haoy1657/stage_2021_pprime/rapport/Rapport technique .pdf

# Rapport technique

Stage de technicien supérieur en conception mécanique Institut P’ CNRS UPR3346 – département GMSC – équipe ROBIOSS du 12 avril 2021 au 18 juin 2021

Hao Yuan

Etudiant
Génie Mécanique et Productique
Institut Universitaire de Technologie de Poitiers M Antoine Eon

Tuteur de stage
Maître de Conférence
M Arnaud Decatoire

Tuteur de stage
Ingénieur de Recherche

M Julian Le rouzic

Enseignant référent
Génie Mécanique et Productique Institut Universitaire de Technologie de Poitiers

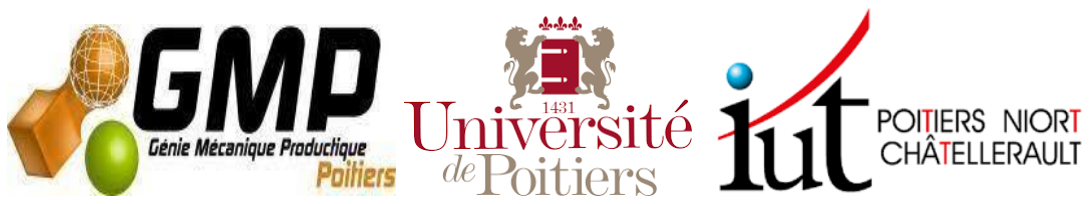
[picture p16: figure]

## Sommaire

Sommaire | 2
Introduction | 3
Missions | 4
Missions 1:l’analyse cinétique et dynamique et l’inertie d’utilisateur | 4
l’analyse cinétique et dynamique | 4
L’inertie d’utilisateur | 7
Mission 3:Dimensionnement du plateau et la roue | 11
1.La roue | 11
2.Le plateau | 15
Mission 3: conception sur Solidworks | 18
Conclusion | 20

## Introduction

Dans le cadre de mes études, j’ai réalisé un stage de dix semaines au sein du laboratoire l’institut pprime (cnrs). L’institut P’ est un laboratoire de recherche des domaines des Sciences Physiques et des Sciences de l’Ingénierie. Pendant ce stage ,j’ai travaillé pour concevoir un dispositif qui permet d’illustrer la loi de conservation du moment cinétique.Ce dispositif est composé en deux parties , la première partie consiste en un plateau permettant une rotation libre autour de l’axe vertical,La deuxième partie correspond à une roue motorisée tenue par les élèves / utilisateurs. Le mouvement de rotation (vitesse angulaire) de cette roue doit pouvoir être pilotée par les élèves / utilisateurs.C’est pour ca que le mase de la roue ne doit pas etre tres lourd,on a pris deux kg comme son masse,et on joue principalement sur sa vitesse de rotation.quand l’angle du bras est nul , Qu'il change de vitesse ou de poids de roue, le plateau ne peut pas tourner.Donc pour le rendre bien fonctionner , l’angle du bras d’utilisateur (theta 2) ne doit pas être nul.
Dans ce rapport , je vais présenter principalement trois missions
La première mission concerne l'analyse cinétique et dynamique,c’est pour essayer de trouver l’équation de mouvement qui lie l'inertie de la roue et la vitesse de rotation du plateau, cette équation nous permet de dimensionner le plateau et la roue.Dans l’équation du mouvement, on a constaté qu’il concerne une constante (B1 l’inertie du corps de l’utilisateur ), pour obtenir la valeur B1, on a établir un tableau d’excel pour calculer les inerties d’utilisateur automatiquement .
La deuxième mission concerne le dimensionnement du plateau et de la roue ,tout d’abord,on a établi un tableau de simulation selon l’équation du mouvement, c’est pour trouver les valeurs le plus pertinent (l’inertie de la roue, sa masse…..) pour que la vitesse de rotation du plateau ne soit pas très élevée.Pour le dimensionnement du plateau ,principalement,on a travaillé pour choisir le bon roulement (le plue économique , la durée de
vie | ), pour faire ca , on a proposé sept contraintes et établi un grand tableau (il y a 600
roulement dedans ),finalement l’excel nous a proposé 12 roulements ,parmi ces 12 roulements ,on a choisi le roulement 7207 BE-2RZP, parce que ce roulement est déjà étanche,c’est très pratique.
Après avoir terminé ces deux missions précédentes , on a travaillé sur solidworks pour la modélisation de la conception , mais malheureusement , on a pas eu temps pour concevoir et modéliser la roue, pour le plateau ,on l’a bien modélisé.Et ça ,c'est la troisième mission

## Missions

### I. Missions 1:l’analyse cinétique et dynamique et l’inertie d’utilisateur 1. l’analyse cinétique et dynamique

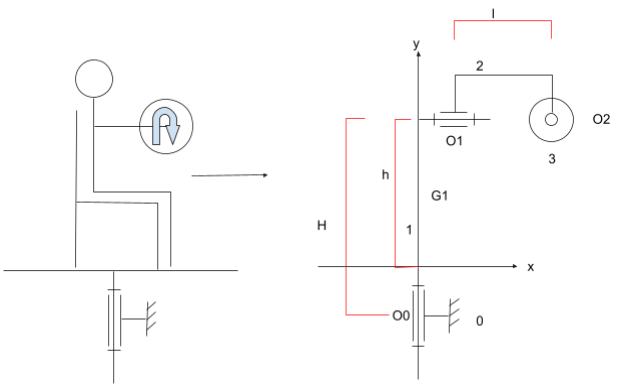
[picture p17: figure]

Illustration 1 la modèle simple

La premier mission pour moi est l’analyse cinétique et dynamique , ce calcul m’a occupé plus de trois semaines , les connaissances qu’on a utilisé ne sont pas très difficiles , elles sont toutes enseignées à l'iut, mais il y a nombre de variables , ca a rendu le calcul plus complexe,mais finalement j’ai réussi à le finir.
L’objectif pour l’analyse cinétique et dynamique est d' essayer de trouver une équation qui lie l’inertie de la roue et le plateau. On veut trouver cette équation, c’est parce qu’on veut contrôler la vitesse de rotation du plateau pour qu’il ne soit pas très rapide( Dans la simulation derrière , on prend PI/2 comme le valeur maximum de la vitesse.)
Pour faciliter le calcul , on a supposé qu’il y a quatre solides(0- le bâti,1-le corps principal d’utilisateur+le plateau,2-les deux bras d’utilisateur,3-la roue), Chacun a un système de coordonnées unique:

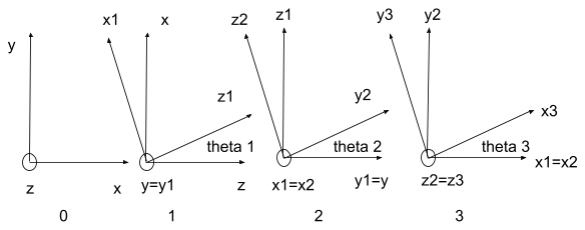
[picture p18: figure]

Illustration 2 les systèmes de coordonnées des solides

Les hypothèses qu’on a fait avant le calcul:

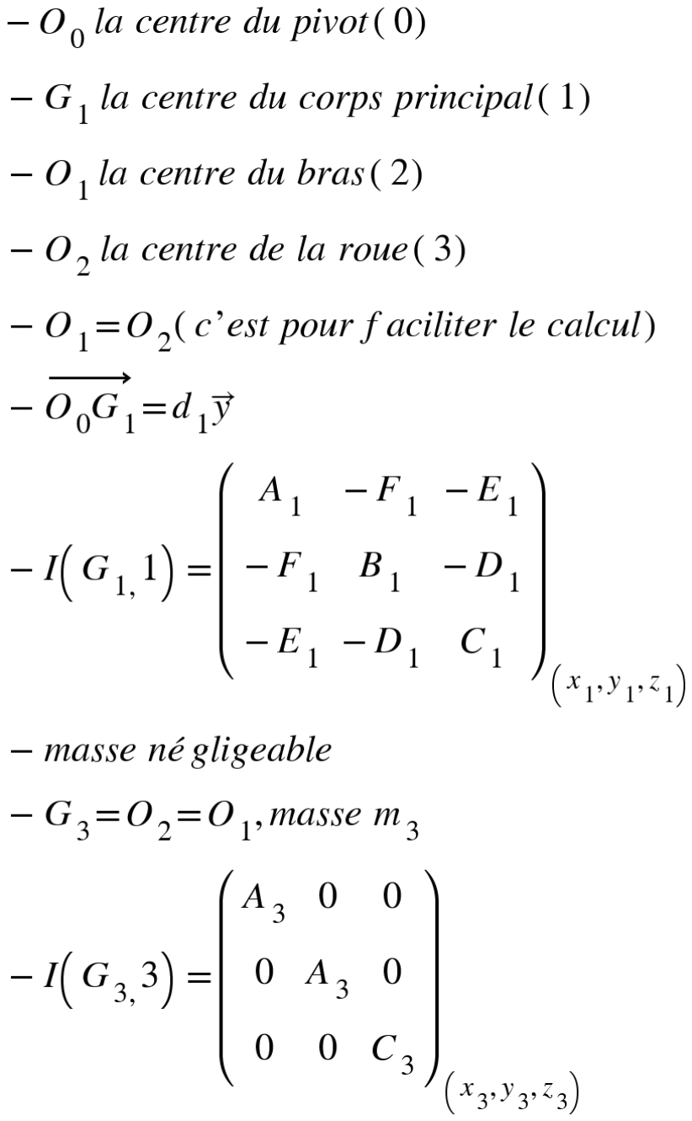
[picture p19: figure]

Bilan action mécanique
-pesanteur sur 1 et 3
-Couple moteur de 2->3 en O2 /z2 -Couple humain e 1->2 en O2/x1

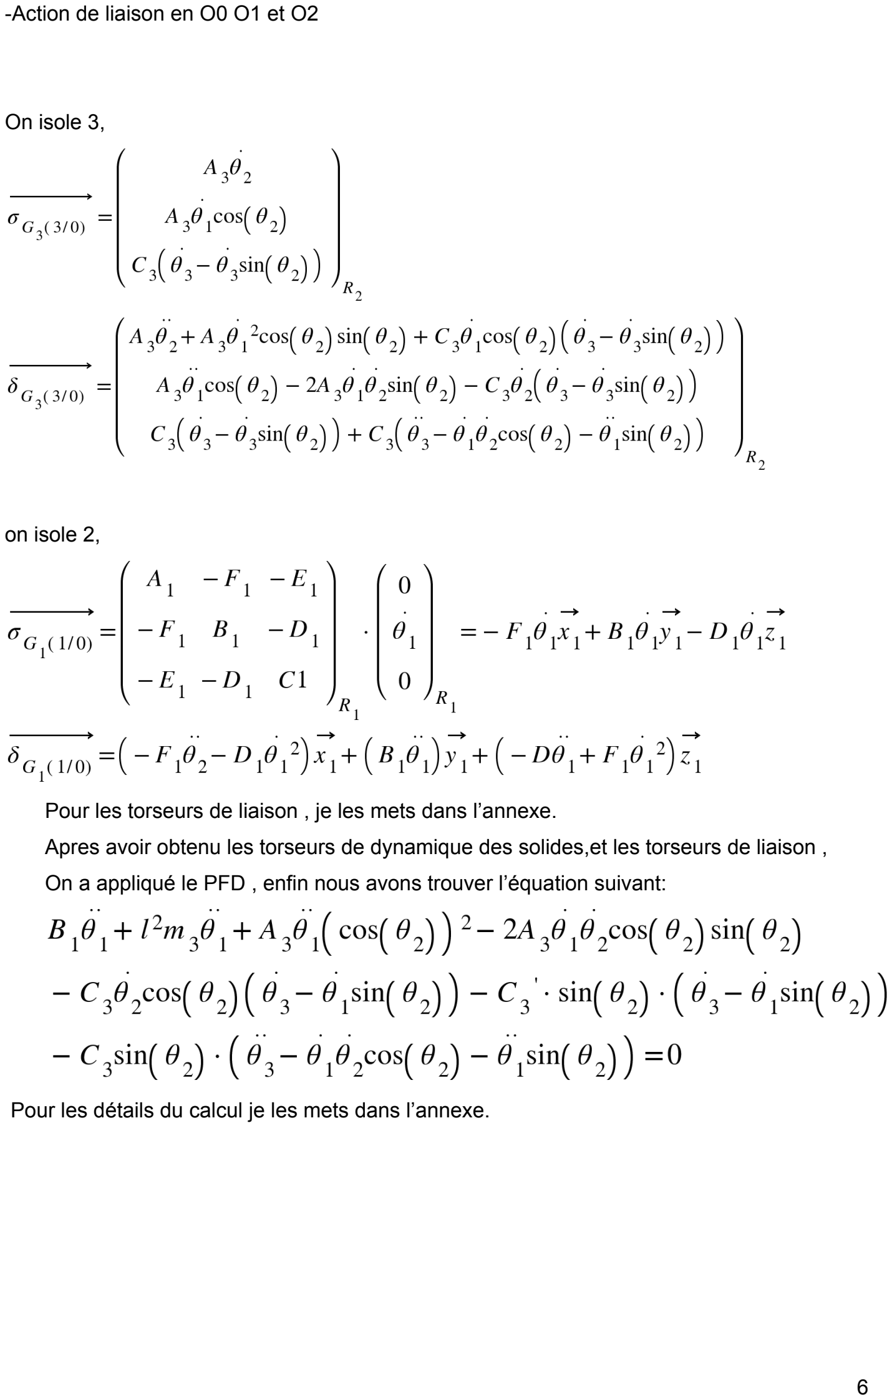
[picture p20: page 6]

-Action de liaison en O0 O1 et O2

On isole 3,

on isole 2,

Pour les torseurs de liaison , je les mets dans l’annexe.
Apres avoir obtenu les torseurs de dynamique des solides,et les torseurs de liaison , On a appliqué le PFD , enfin nous avons trouver l’équation suivant:

Pour les détails du calcul je les mets dans l’annexe.

### 2. L’inertie d’utilisateur

Dans l’équation précédent , on constate qu’il a une constante d’inertie du corps(B1) Donc on doit essayer de trouver la valeur de B1 pour qu’on puisse faire la simulation suivante.

En biomécanique, le corps humain peut être vu comme composé de nombreuses parties différentes.Si on veux calculer l’inertie d’un humain, il faut calculer l’inertie de chaque partie , Les inerties calculées ne sont pas appliquées en même point , on a utilisé le théorème de HUYGENS.
Le théorème de Huygens permet de relier les moments d'inertie d'un solide par rapport à un axe et du solide par rapport à l'axe parallèle à et passant par G : où a désigne la distance entre les deux axes de rotation.
Voici est la formule du théorème de Huygens

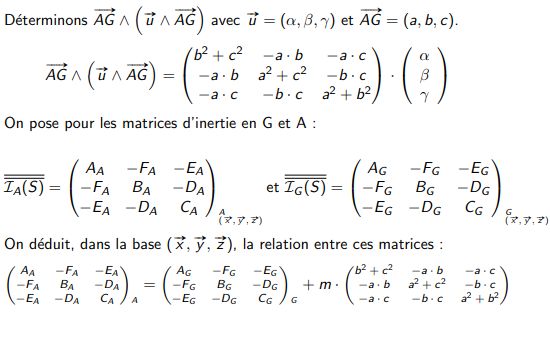
[picture p21: figure]
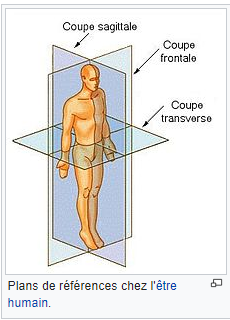
[picture p22: figure]

Il y a aussi autre chose qui doit être fait pendant ce calcul ,c’est d’appliquer le système de référence en anatomie pour chaque partie de corps,parce que l’inertie des différentes parties qu’on a obtenue finalement sont appliquées en leur propre système de coordonnées.Nous devons tous les convertir dans le même système de coordonnées(sagittale, frontale, transversale)

ETAPE 1 calculer le coefficient de corrélation
La première chose que nous devons faire est de calculer le coefficient de proportionnalité entre la masse et la longueur de chaque partie du corps humain et la hauteur et la masse totale du corps humain sur la base d'un échantillon de table.Ce tableau est un exemple de tableau résumé par des chercheurs sur la base de données massives. Voici le tableau :

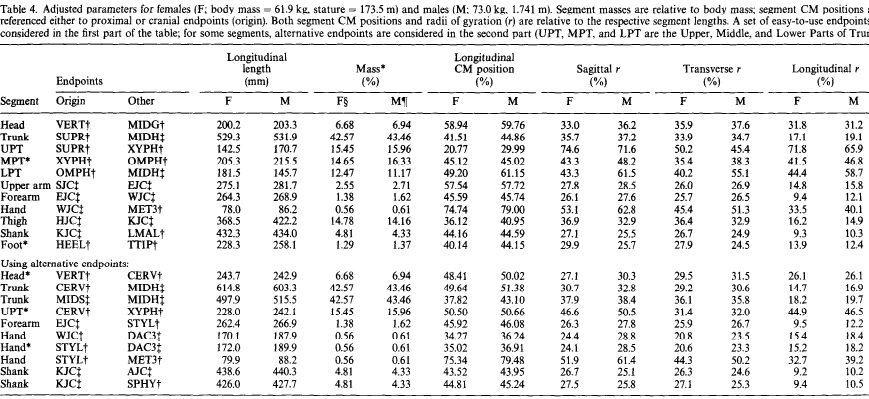
[picture p23: figure]

Illustration 3 tableau résumé Je vais ajouter ce tableau dans l'annexe , ça sera plus clair pour vous. Finalement , on a obtenu le tableau de coefficient ci dessous

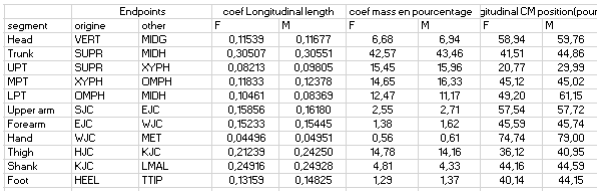
[picture p24: figure]

Illustration 4 tableau du coefficient Avec ce tableau, nous pouvons calculer la masse et la longueur de chaque partie de l'utilisateur en fonction de sa taille et de son poids.Nous pouvons aussi savoir la position de la centre d’inertie avec ce tableau.Parce que ce tableau contient également les informations de la position de la centre de masse.
La figure suivante est plus claire，La position du point de masse est à 44,86 pourcent de la longueur totale du tronc.

Illustration 5 position du point de masse

Etape 2 Application du théorème de HUYGENS

La formule du HUYGENS est pour changer le point appliqué d’inertie.il faut savoir le vecteur AG tout d’abord.
Le vecteur sert à calculer une matrice qui est une partie de cette formule

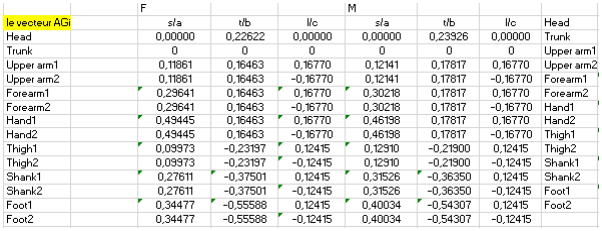
[picture p25: figure]

Illustration 6 matrice du vecteru AG Selon ce tableau on sait les trois valeurs (a,b,c),et puis on fait le calcul comme le tableau ci dessous

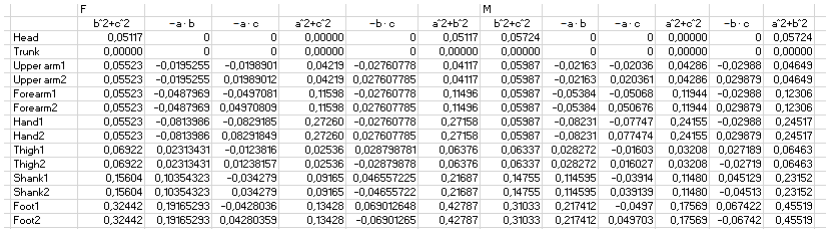
[picture p26: figure]

Illustration 7 matrice calculé

Nous ajoutons la valeur obtenue dans le tableau ci-dessus à sa propre inertie(l’inertie en sa centre de gravité),on obtient les l’inertie en la centre de gravité du corps global.
Et puis , on ajoute tous les résultats pour obtenir l’inertie totale du corps au centre du tronc,comme le tableau ci dessous

Illustration 8 l’inertie totale du corps au centre du tronc Ces inerties qu’on a obtenu ne sont pas appliquées au centre du corps , il est au centre du tronc.Donc on doit le convertir au centre du corps en utilisant HUYGENS.
Avant le calcul, il nous faut savoir la position du centre du corps en utilisant le théorème BARYCENTRE.
Voici est le tableau l’inertie du corps au centre:
Illustration 9 l’inertie totale du corps au centre du corps

On doit connaître l’inertie du plateau aussi puisqu'on pense que le plateau et l’humain sont dans le même solide(1)
Avec solidworks , nous pouvons connaître l’inertie d’une solide facilement ,solidworks peut nous aider à calculer l’inertie d’un solide lui-même.

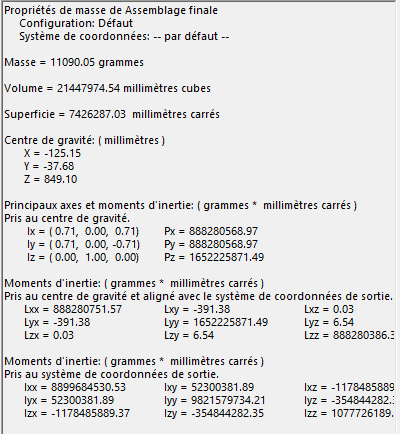
[picture p27: figure]

Illustration 10 l’inertie du plateau donné par solidworks

Et enfin , on a ce tableau qui nous dit l’inertie du corps et plateau en la centre du corps en les ajoutant:

Illustration 11 l’inertie du plateau et d’humain

### II. Mission 3:Dimensionnement du plateau et la roue

1.La roSue

La roue est composée en trois parties comme l’illustration ,la vitesse de la rotation et l’inertie peuvent être contrôlées par l’ordinateur à distance.

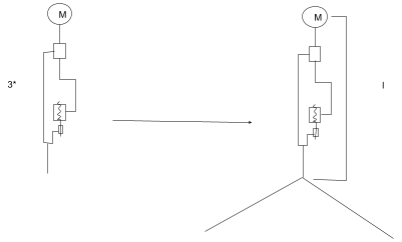
[picture p28: figure]

Illustration 12 la modèle de la roue Dans la première mission, on a trouvé une équation qui lie l’inertie de la roue et la vitesse de rotation du plateau ,et nous avons aussi établir une tableau d’excel pour calculer la matrice d’inertie du corps et plateau en le centre de gravité du corps.Cette simulation a l’objectif de trouver une valeur pertinente de l'inertie et des autres paramètres de la roue pour que la vitesse de rotation de la roue ne soit pas très rapide.
Nous avons proposé deux cas pour la simulation de la roue.

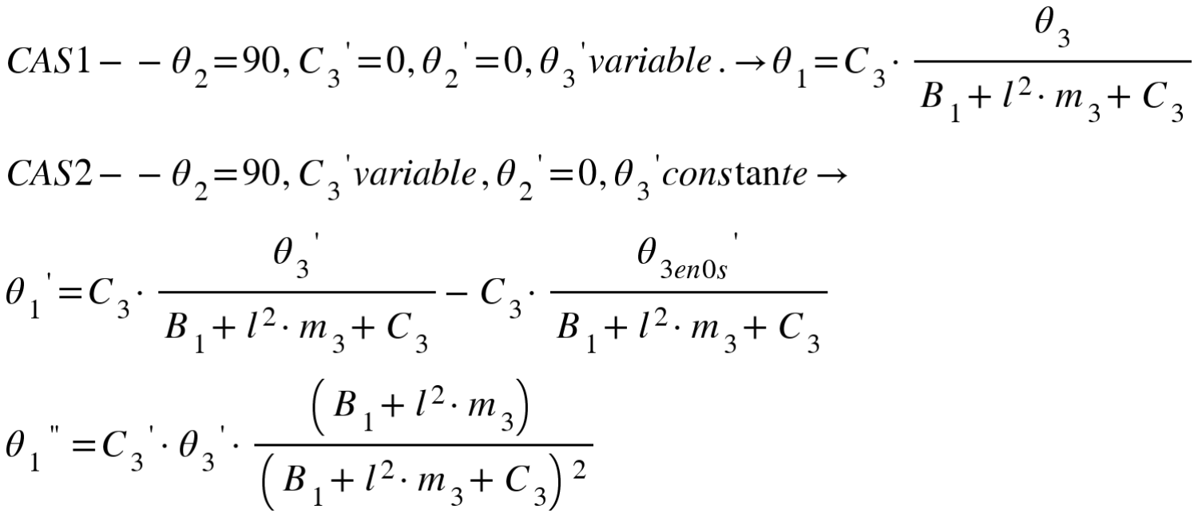
[picture p29: figure]

Le premier cas : l’angle du bras est une constante (PI/2),l’inertie de la roue est une constante ,on joue sur la vitesse de rotation de la roue ,si on veut laisser le plateau tourner, l’accélération de la roue ne doit pas être zéro.On a proposé un modèle comme ci-dessous:

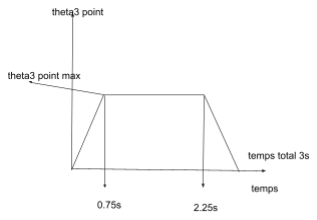
[picture p30: figure]

Illustration 13 theta 3 point en fonction du temps

Le deuxième cas:l'angle du bras est une constante(PI/2),la vitesse de rotation de la roue est une constante, l’inertie variable. Pareil, on a proposé un modèle pour C3 point:

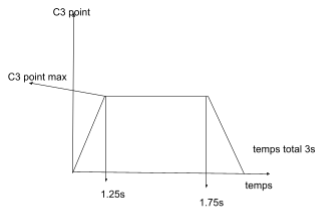
[picture p31: figure]

Illustration 14 C3 point en fonction du temps Et puis on a établi un tableau de résultat de simulation selon les deux cas proposés et les équations:

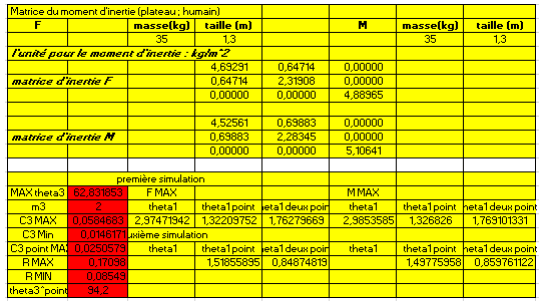
[picture p32: figure]

Illustration 15 résultat de simulation

Cette table est construite sur la base d'une énorme table de simulation,

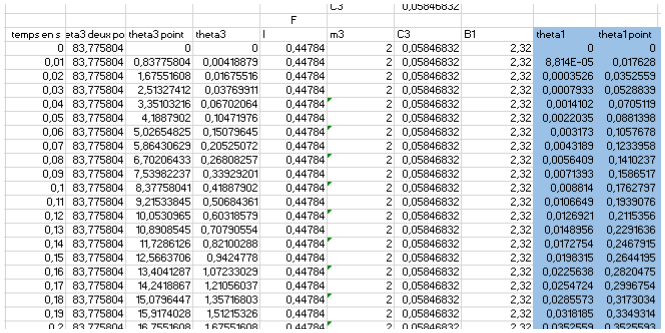
[picture p33: figure]

Dans l’illustration 15 ,le tableau en haut est le tableau d’inertie d'humain et du plateau,le tableau en bas est le tableau de simulation ,les valeurs en rouge sont les paramètres qu’on peut modifier, quand on modifie les valeur en rouge ,les résultat de la simulation change aussi.Nous avons voulu trouver les meilleur paramètres pour que la vitesse de rotation du plateau ne soit pas très rapide.La roue doit etre tenu par les utilisateur , c’est pour ca que le mase de la roue ne doit pas etre tres lourd,on a pris deux kg comme son masse,et on joue principalement sur sa vitesse de rotation.quand l’angle du bras est nul , Qu'il change de vitesse ou de poids de roue, le plateau ne peut pas tourner.Donc pour le rendre bien fonctionner , l’angle du bras d’utilisateur (theta 2) ne doit pas être nul.
Enfin, après plusieurs simulations,nous avons proposé deux modes (mode enfant ,mode adulte):

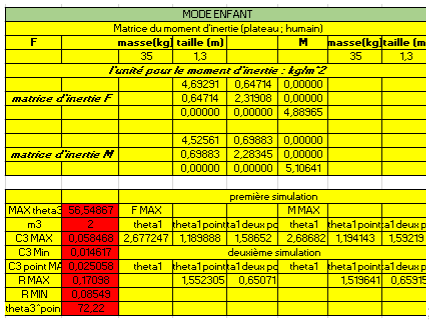
[picture p34: figure]

;
Illustration 16 mode enfant

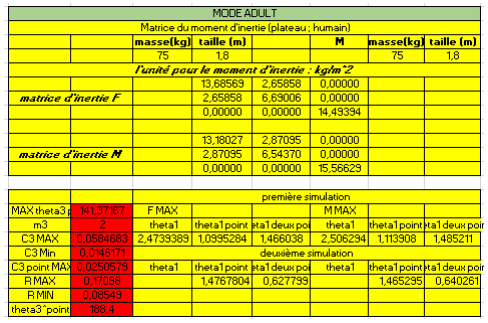
[picture p35: figure]

Illustration 17 mode adulte (Lors de la simulation, nous avons constaté que la masse de la roue a peu d'effet sur la vitesse du plateau , on prend en compte principalement C3 et theta 3)

2.Le plateau

Le plateau est composé en trois parties , la première partie est le disque en bois,Le diamètre de ce disque est d'un mètre et l'épaisseur est
de deux centimètres.La deuxième partie est le bâti en métal (aluminium),on a choisi le motedis 45*45,
La troisième partie est le boîtier du roulement ,dans le dimensionnement du plateau , le choix du roulement est le plus important.
On a plusieurs type de roulement qui peuvent être choisi:
-un montage du roulement avec contact oblique(bille,rouleau)
-un roulement combiné
-un roulement rouleaux croisé
Pour le troisième roulement , mon équipe en a trouvé un pertinent , son prix est 240 euros,moi j’ai travaillé sur le choix du premier type roulement-un montage du roulement avec contact oblique(bille,rouleau).Enfin , on a comparé les prix des roulement ,Choisissant le roulement le plus économique.

Pour choisir le roulement , on a proposé cinq contraintes:
->charge statique équivalente doit être inférieur à charge statique de la base du roulement (P0<C0).
->durée de vie du roulement doit être supérieur à 20000h.

->le contrainte(la traction et le cisaillement) doit être inférieur à la limite élasticité du matériaux avec “k=2”.
->l’angle de déformation en les points du roulement doit être inférieur à deux minutes d’angle(Pi/5400). il est donné par le constructeur
->la distance au dessus et au dessous des deux roulements doit être inférieur à l'épaisseur de ces deux roulement (h>2*B).
--le travaille sur solidworks, effectuer la modélisation selon les dimensions qu’on a obtenues.
Ce roulement doit avoir une longue durée de vie et être capable de résister à la gravité de l'utilisateur.Dans le même temps, le diamètre intérieur du roulement détermine l'épaisseur de l'arbre et le diamètre de l'arbre doit pouvoir résister à une force suffisante.
La première chose que j’ai faite était d'établir un tableau avec tous les paramètres des roulements (d,D,B,C,C0,X,Y0,Y1,Y2,e), ces paramètres peuvent être trouvés sur le site SKF.

Et puis on doit calculer sa Charge dynamique équivalente et Charge statique équivalente
Dans le dossier du constructeur ,on y a trouvé le modèle du calcul pour ce type de roulement.

Le modèle du calcul du roulement :
Charge dynamique équivalente-> Roulements isolés et appariés en tandem :
Fa/Fr ≤ e → P = Fr
Fa/Fr > e → P = X Fr + Y2 Fa.
Roulements montés par paire selon disposition en O ou en X Fa/Fr ≤ e → P = Fr + Y1 Fa
Fa/Fr > e → P = X Fr + Y2 F
Charge statique équivalente->
Roulements isolés et appariés en tandem :
P0 = 0,5 Fr + Y0 Fa
P0 < Fr → P0 = Fr
Roulements montés par paire selon disposition en O ou en X : P0 = Fr + Y0 Fa.

On a ajouté la méthode du calcul dans le tableau ,et puis , on a calculé la durée de vie des différentes des roulements.

Après avoir chercher des informations sur le site ,on a trouvé une caractéristique des roulements.Dans ce document , il est indiqué que le défaut d'alignement admissible est 2 minutes d'angle pour montage en O, et 4 minutes d'angle pour montage en X.

Donc on a calculé l’angle déformation pour chaque roulement.

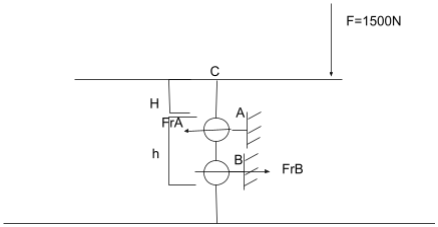
[picture p36: figure]

Illustration 18 modèle du plateau

Après calcul ,l’angle déformation en roulement A:

L’angle déformation en roulement B: | .
Et puis on a ajouté ces deux formules dans le tableau.
Dans le processus de calcul, nous avons également trouvé une formule :Fr*h=F/2=750

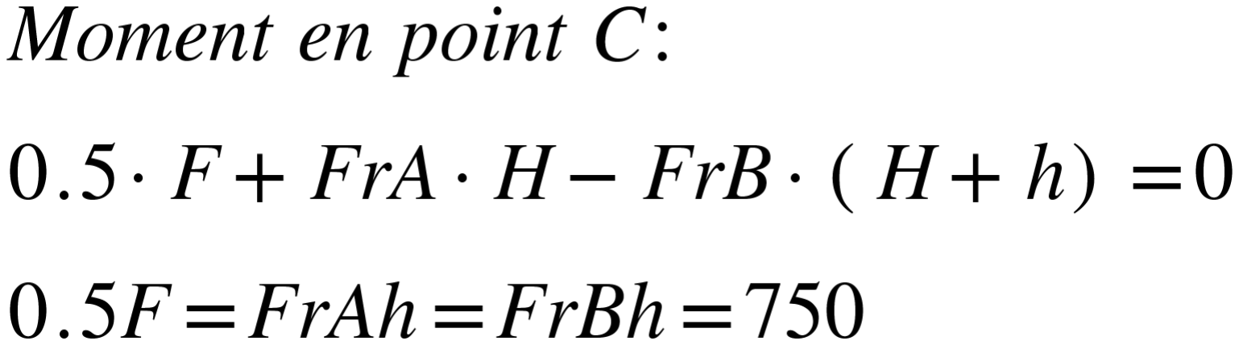
[picture p37: figure]

Après avoir terminé le formulaire, nous avons commencé notre simulation，On veut savoir quel roulement est le moins cher si la valeur h est la plus petite.Finalement , on a trouvé , le valeur le plus petit pour h est 35 mm, dans ce cas , on a 12 roulements au choix.

On a pris le roulement 7207 BE-2RZP,parce que ce roulement est étanche.Dans la partie de montage , on a pas besoin de monter un étanchéité.

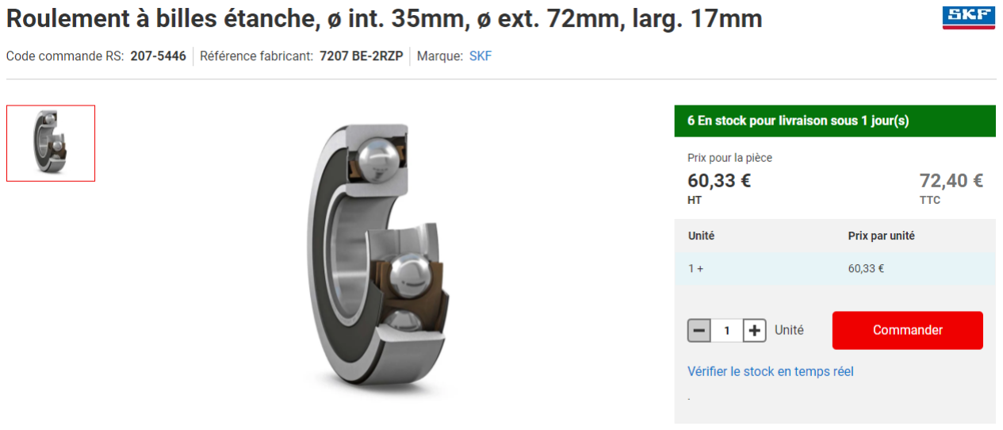
[picture p38: figure]

Illustration 19 Le prix du roulement 7207 BE-2RZP sur 123roulement Le prix pour ce roulement est 72..40 euros , il est inférieur à 240 euros, c’est plus économique de prendre ce roulement.

### Mission 3: conception sur Solidworks

Après de dimensionnement ,on a commencé conception sur solidworks,et voici est la modèle du plateau j’ai conçu:

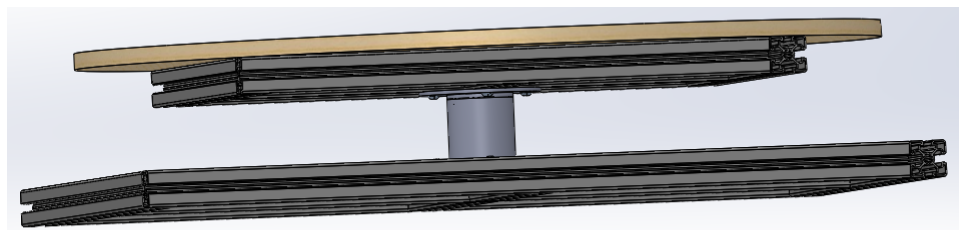
[picture p39: figure]

Illustration 20 modèle du plateau sur solidwork

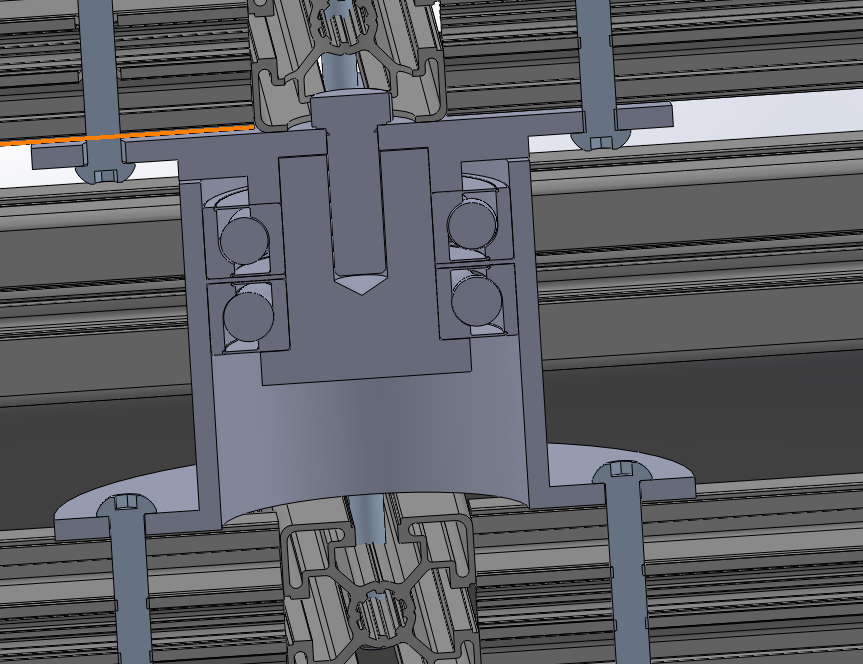
[picture p40: figure]

Illustration 21 vue de coupe

et voici est la vue de coupe du boîtier du roulement.il y a du jeu entre l'arbre et la plaque haute, c’est pour régler la précharge , quand on serre la vis de serrage, ce jeu diminue, et la précharge augmente.

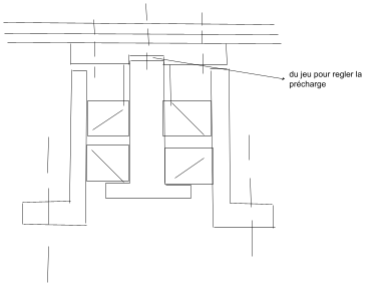
[picture p41: figure]

Illustration 22 le jeu pour régler la précharge Pour le conception du plateau , j’ai pas eu le temps pour le finir.Mais l'idée est claire ,les paramètres pour la roue sont bien trouvés.Nous devons juste trouver un moyen de transformer nos idées en réalité.

## Conclusion

J'ai la chance d'avoir pu faire un stage de deux mois dans le laboratoire du CNRS, ce qui a grandement renforcé mes connaissances que j’ai apprises à l’IUT.
La tâche qui m'a été confiée est pratiquement terminée，il manque juste la conception de la roue,mais l'idée de base a été donnée dans le rapport.

Pour faire simple, j'ai réalisé trois points dans ce stage，tout d’abord,j’ai fait l’analyse cinétique et dynamique et l’inertie d’utilisateur, c’est pour trouver l’équation du mouvement
qui | peux | etre | utilisée | dans | la | simulation.

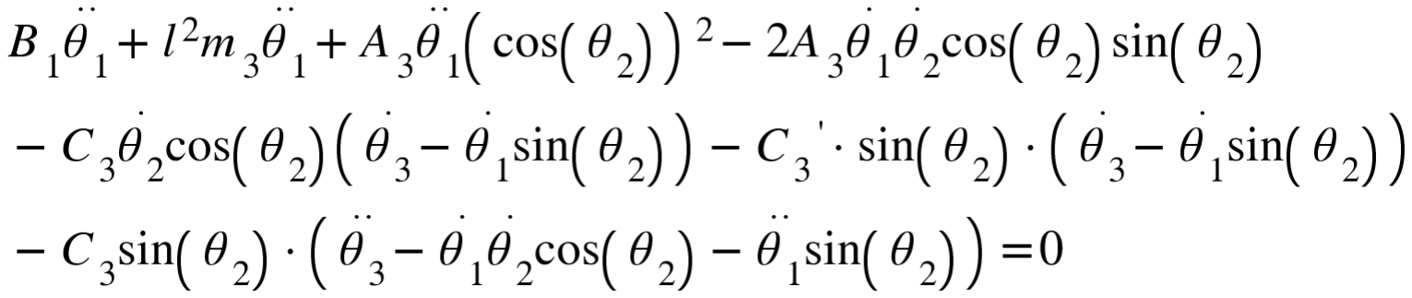
[picture p42: figure]

l’équation du mouvement
Et puis j’ai fait le dimensionnement du plateau et la roue ,proposé des paramètres de fonctionnement .Pour le plateau ,la chose la plus importante est le choix du roulement ,après l’étude et la simulation, on a pris le roulement 7207 BE-2RZP, c’est un roulement étanche. Et pour la roue ,on a proposé deux modes de fonctionnement (enfant et adulte),sa masse totale est de 2 kg,le temps de fonctionnement de la roue doit être de 3s ,et les autres paramètres de la roue sont bien indiqués dans le rapport.
Finalement, j’ai travaillé sur Solidworks ,pour la modélisation du plateau.

Pour ces missions , aucune échéance particulière ne m’avait été indiquée. Aussi j’ai pu travailler à mon rythme tout en m'efforçant de fournir un résultat que j’espère suffisamment avancé pour qu’il puisse bénéficier à l'entreprise.

Je suis très reconnaissant au CNRS de m'avoir offert cette opportunité de stage,Si je dois me dire quel est mon plus gros gain durant ce stage，Je pense que c'est une attitude envers les choses, tant que les choses sont prises au sérieux, rien n'est impossible!
