haoy1657/stage_2021_pprime/rapport/ANNEXE.pdf

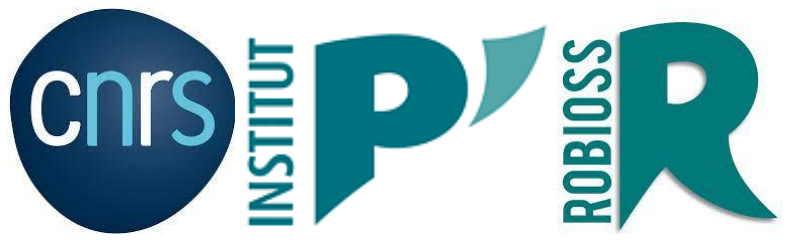
[picture p43: figure]

# ANNEXE

## Stage de technicien supérieur en conception mécanique

## Institut P’ CNRS UPR3346 – département GMSC – équipe ROBIOSS

## du 12 avril 2021 au 18 juin 2021

# Hao Yuan

## Etudiant

## Génie Mécanique et Productique

## Institut Universitaire de Technologie de Poitiers

# M Antoine Eon

## Tuteur de stage

## Maître de Conférence

# M Arnaud Dectoire

## Tuteur de stage

## Ingénieur de Recherche

# M Julian Le rouzic

## Enseignant référent

## Génie Mécanique et Productique

## Institut Universitaire de Technologie de Poitiers

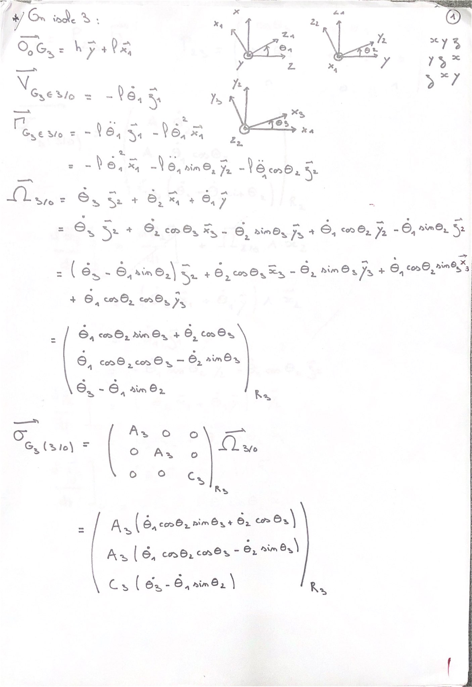
[picture p44: page 2]
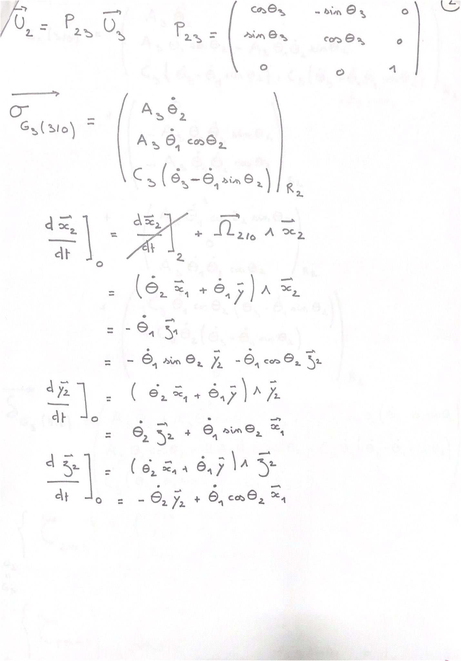
[picture p45: page 3]
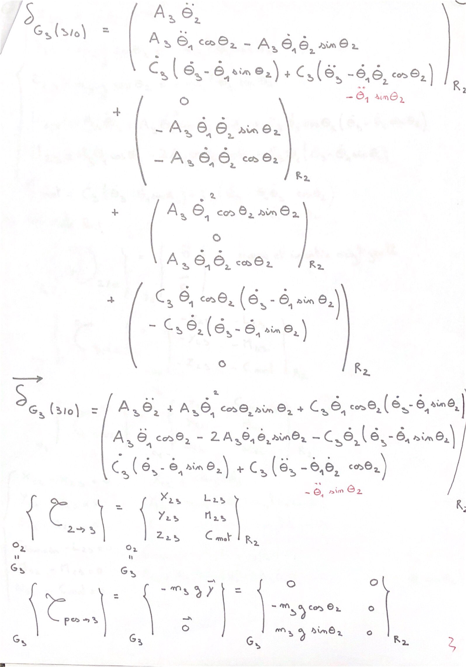
[picture p46: page 4]
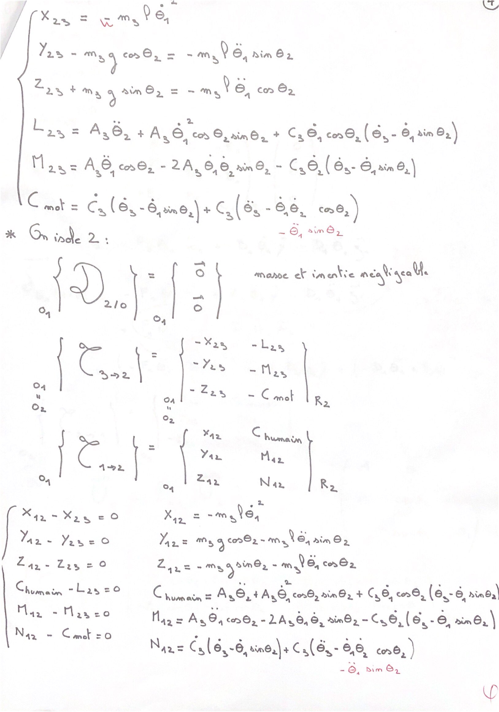
[picture p47: page 5]
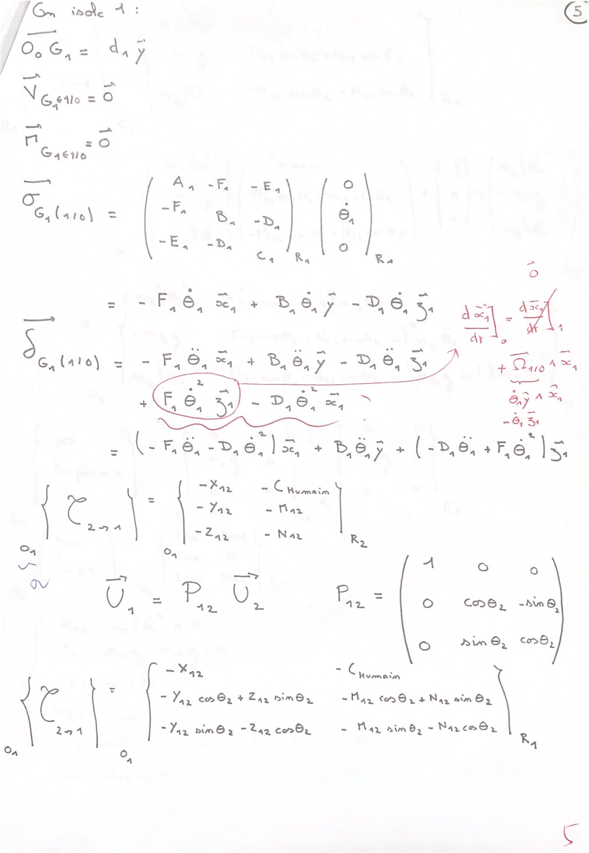
[picture p48: page 6]
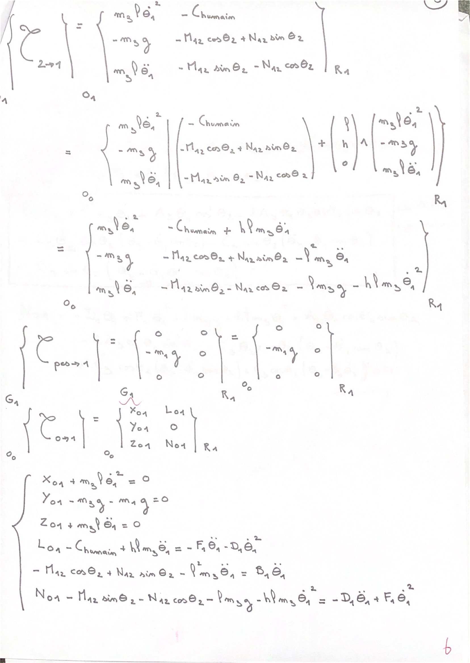
[picture p49: page 7]
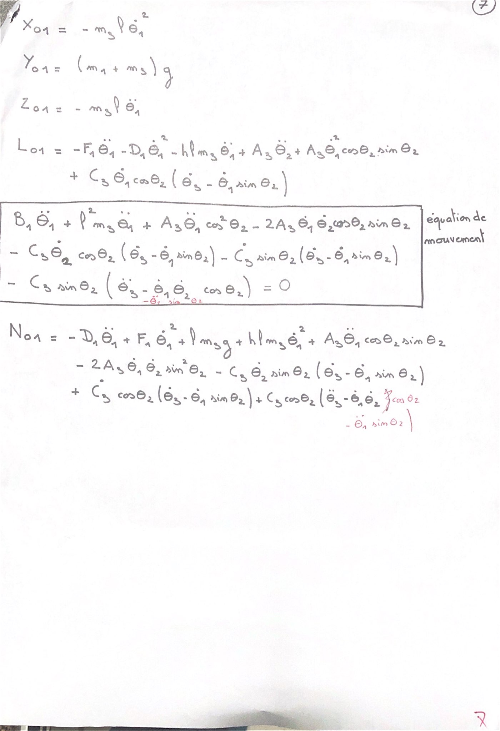
[picture p50: page 8]
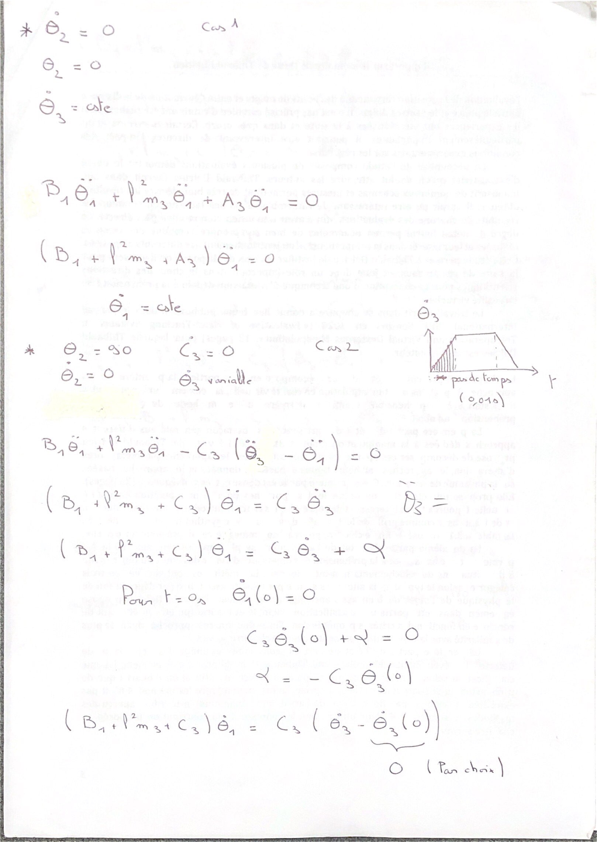
[picture p51: page 9]
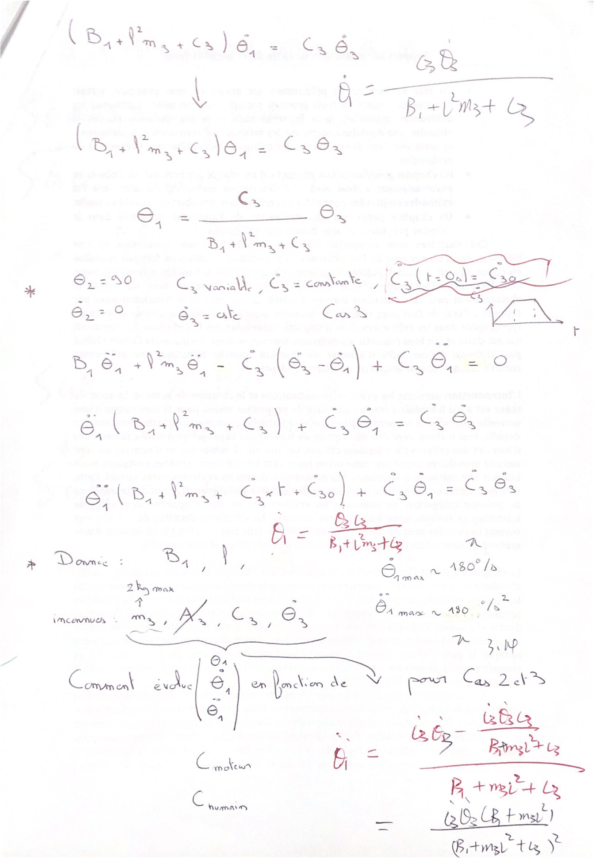
[picture p52: page 10]
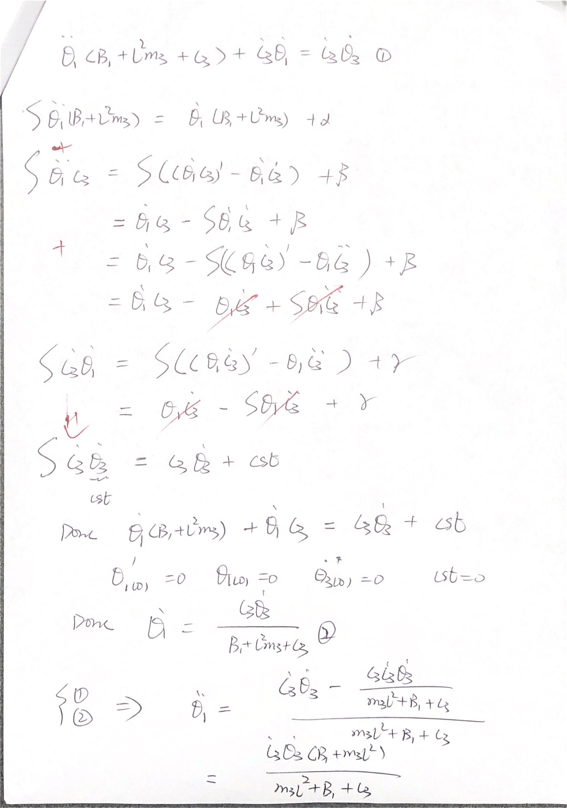
[picture p53: page 11]

## Op´erateur d’inertie

Th´eor`eme de Huygens g´en´eralis´e

On recherche la relation entre la matrice d’inertie en A du solide S et la matrice d’inertie en G le centre d’inertie du solide.

IA(S) ·

#»u =

Z

S

# » AM ∧

#»u ∧

# » AMdm

IG (S) ·

#»u =

Z

S

# » GM ∧

#»u ∧

# » GMdm

soit

IA(S) ·

#»u =

Z

S

# » AG +

# » GM

∧
#»u ∧

# » AG +

# » GMdm

IA(S) ·

#»u =

Z

S

# » AG ∧

#»u ∧

# » AGdm +

Z

S

# » AG ∧

#»u ∧

# » GMdm

+

Z

S

# » GM ∧

#»u ∧

# » AGdm +

Z

S

# » GM ∧

#»u ∧

# » GMdm

## Op´erateur d’inertie

Th´eor`eme de Huygens g´en´eralis´e

Les 2`eme et 3`eme termes sont nuls car Z

S

# » GMdm =

#»0

IA(S) ·

#»u =

Z

S

# » AG ∧

#»u ∧

# » AGdm +

Z

S

# » GM ∧

#»u ∧

# » GMdm

il reste
I Second terme : Z

S

# » GM ∧

#»u ∧

# » GMdm = IG (S) · ~u (op´erateur

d’inertie en G ).

I Premier terme :
d

R
S

# » AG ∧

#»u ∧

# » AGdm = m

# » AG ∧

#»u ∧

# » AG

D’o`u le th´eor`eme de Huygens g´en´eralis´e

IA(S) ·

#»u = IG (S) ·

#»u + m

# » AG ∧

#»u ∧

# » AG | (4)

## Op´erateur d’inertie

Th´eor`eme de Huygens g´en´eralis´e

D´eterminons # » AG ∧
#»u ∧

# » AG

avec #»u = (α, β, γ) et # » AG = (a, b, c).

# » AG ∧

#»u ∧

# » AG

=

b

2 + c

2 | −a · b | −a · c
−a · b | a² + c
| 2 | −b · c
−a · c | −b · c | a² + b
| | 2
- ·

α
β
γ

On pose pour les matrices d’inertie en G et A :

IA(S) =

AA | −FA | −EA
−FA | BA | −DA
−EA | −DA | CA

A
(

#»x ,

#»y ,

#»z )

et IG (S) =

AG | −FG | −EG
−FG | BG | −DG
−EG | −DG | CG

G
(

#»x ,

#»y ,

#»z )

On d´eduit, dans la base (#»x ,

#»y ,

#»z ), la relation entre ces matrices :

AA | −FA | −EA
−FA | BA | −DA
−EA | −DA | CA

A

=

AG | −FG | −EG
−FG | BG | −DG
−EG | −DG | CG

G

+ m ·

b

2 + c

2 | −a · b | −a · c
−a · b | a² + c
| 2 | −b · c
−a · c | −b · c | a² + b
| | 2

## Op´erateur d’inertie

Changement de base

Connaissant la matrice d’inertie du solide S en un point A dans la base B1, on se propose de d´eterminer cette matrice en ce mˆeme point dans la base B2.
Matrice de Passage : On appelle PB1,B2
, la matrice de passage de la base B1 `a la base B2 cette matrice est constitu´ee en colonnes des coordonn´ees des vecteurs de la nouvelle base B2 ´ecrits dans la base d’origine B1. On l’appelle aussi matrice de changement de base, cette matrice est une matrice inversible.
Soit IA(S)B1

et IA(S)B2
les matrices d’inertie d’un solide S respectivement dans la base B1 et la base B2, et PB1,B2

la matrice de
passage de la base B1 `a la base B2, on a alors :

IA(S)B2 = P

−1
B1,B2
- IA(S)B1
- PB1,B2

avec P

−1
B1,B2

la matrice inverse de PB1,B2
