haoy1657/stage_2021_pprime/conception/Motedis Profile 45x45L B-Type slot 10/profilé alu sup.SLDASM

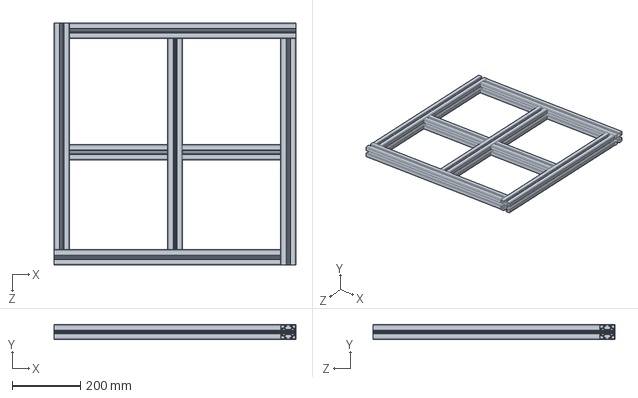
[picture p54: CAD file, 2023-12-29]
conception/Motedis Profile 45x45L B-Type slot 10/profilé alu sup.SLDASM
707.1 x 45.0 x 707.1 mm
Motedis Profile 45x45L B-Type slot 10.stp x 7
