haoy1657/stage_2021_pprime/conception/vis M8 x20 pas 1.25/assemblage plateau inf.SLDASM

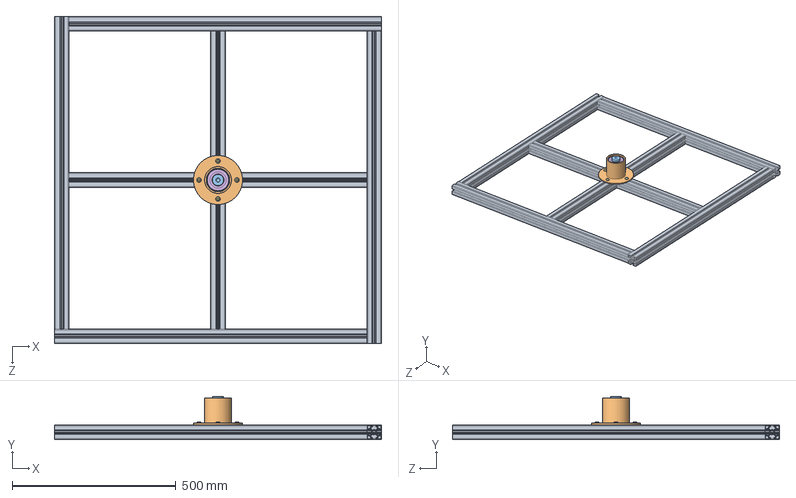
[picture p55: CAD file, 2023-12-29]
conception/vis M8 x20 pas 1.25/assemblage plateau inf.SLDASM
1000.0 x 131.9 x 1000.0 mm
Motedis Profile 45x45L B-Type slot 10.SLDPRT 3 x 7
boitier
arbre
SKF_7207_BE_2RZP_3 x 24
SKF_7207_BE_2RZP_16 x 2
SKF_7207_BE_2RZP_18 x 2
fixe00e5601 x 4
