haoy1657/stage_2021_pprime/conception/114864418-7-snr_51104_2/snr_51104_2.SLDASM

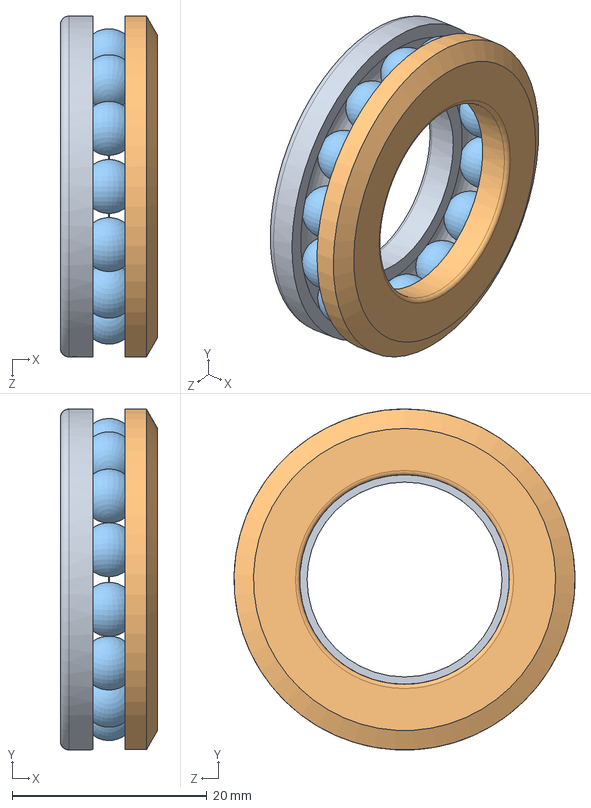
[picture p56: CAD file, 2023-12-29]
conception/114864418-7-snr_51104_2/snr_51104_2.SLDASM
10.0 x 35.0 x 35.0 mm
snr_51104_2_01
snr_51104_2_02
snr_51104_2_03
