haoy1657/stage_2021_pprime/conception/la roue/Assemblage2.SLDASM

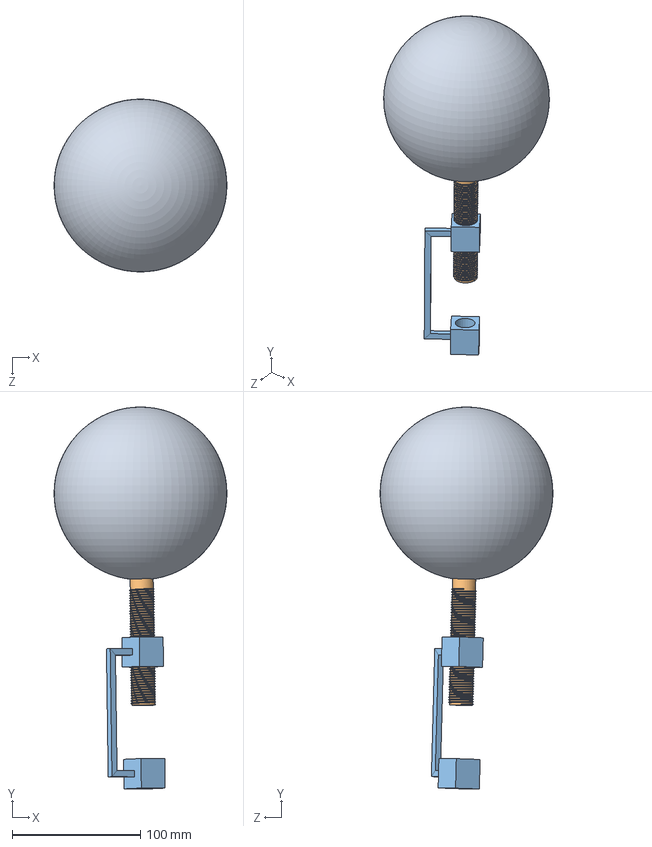
[picture p57: CAD file, 2023-12-29]
conception/la roue/Assemblage2.SLDASM
134.6 x 297.4 x 134.6 mm
Pièce1
Pièce2
Pièce3
