haoy1657/stage_2021_pprime/conception/assemblage plateau sup.SLDASM

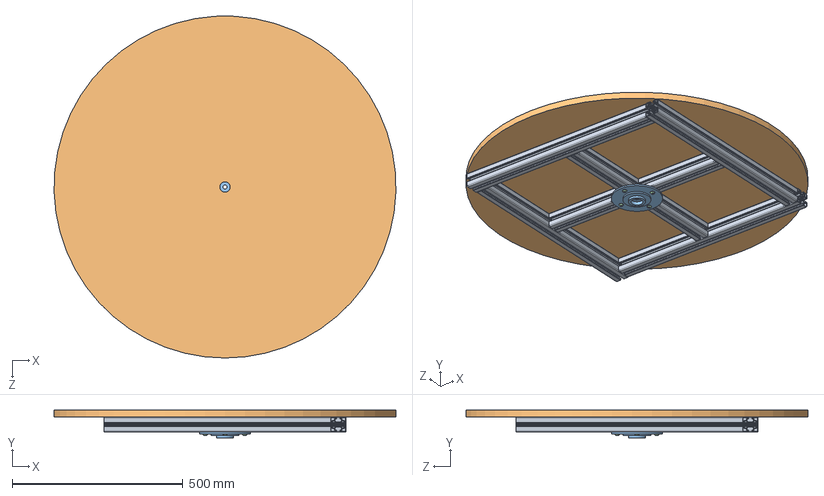
[picture p58: CAD file, 2023-12-29]
conception/assemblage plateau sup.SLDASM
999.6 x 81.8 x 1000.0 mm
Motedis Profile 45x45L B-Type slot 10.stp x 7
plateau du bois
plaque sup
fixe00e5601 x 4
