haoy1657/stage_2021_pprime/conception/socle.SLDASM

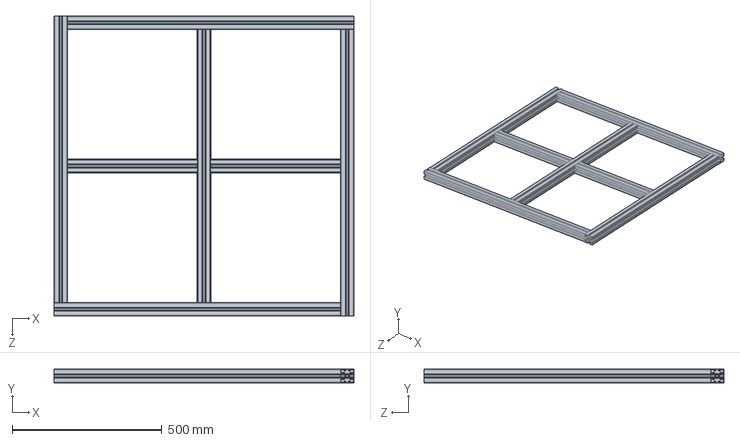
[picture p59: CAD file, 2023-12-29]
conception/socle.SLDASM
1000.0 x 45.0 x 1000.0 mm
Motedis Profile 45x45L B-Type slot 10.SLDPRT 3 x 7
