haoy1657/stage_2021_pprime/conception/Assemblage finale.SLDASM

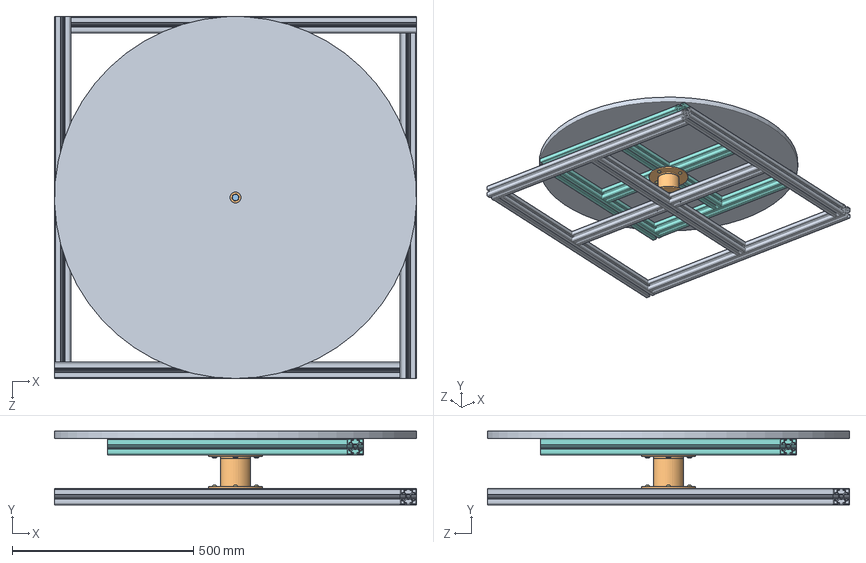
[picture p60: CAD file, 2023-12-29]
conception/Assemblage finale.SLDASM
1000.0 x 203.1 x 1000.0 mm
Motedis Profile 45x45L B-Type slot 10.SLDPRT 3 x 7
boitier
arbre
SKF_7207_BE_2RZP_3 x 24
SKF_7207_BE_2RZP_16 x 2
SKF_7207_BE_2RZP_18 x 2
fixe00e5601 x 8
Motedis Profile 45x45L B-Type slot 10.stp x 7
plateau du bois
plaque sup
din_en_24018_m12x35
