haoy1657/stage_2021_pprime/conception/Assemblage boitiers du roulement .SLDASM

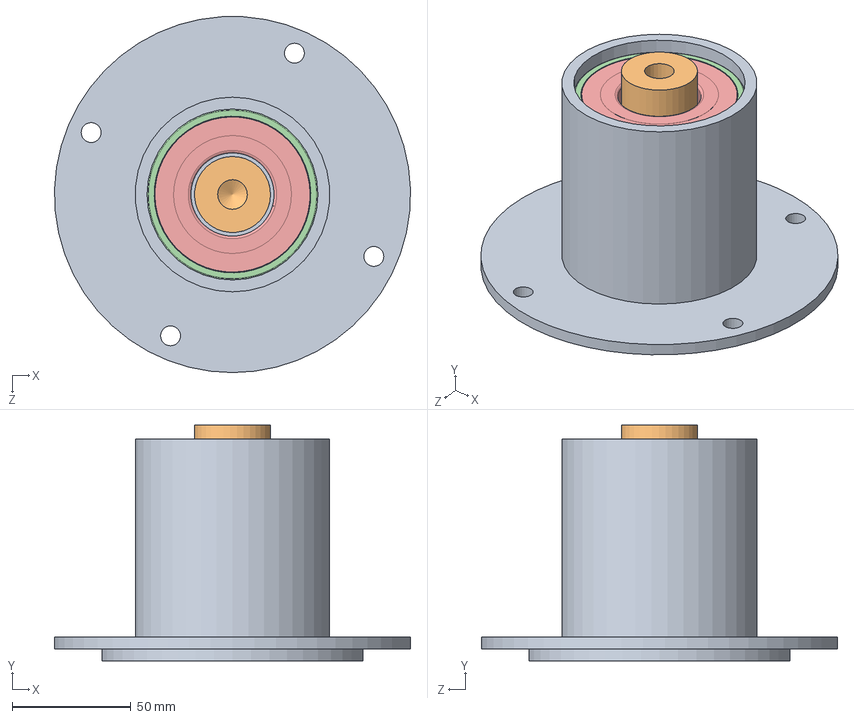
[picture p61: CAD file, 2023-12-29]
conception/Assemblage boitiers du roulement .SLDASM
149.9 x 99.3 x 150.0 mm
boitier
arbre
SKF_7207_BE_2RZP_3 x 24
SKF_7207_BE_2RZP_16 x 2
SKF_7207_BE_2RZP_18 x 2
