haoy1657/stage_2021_pprime/conception/la roue/Pièce4.SLDPRT

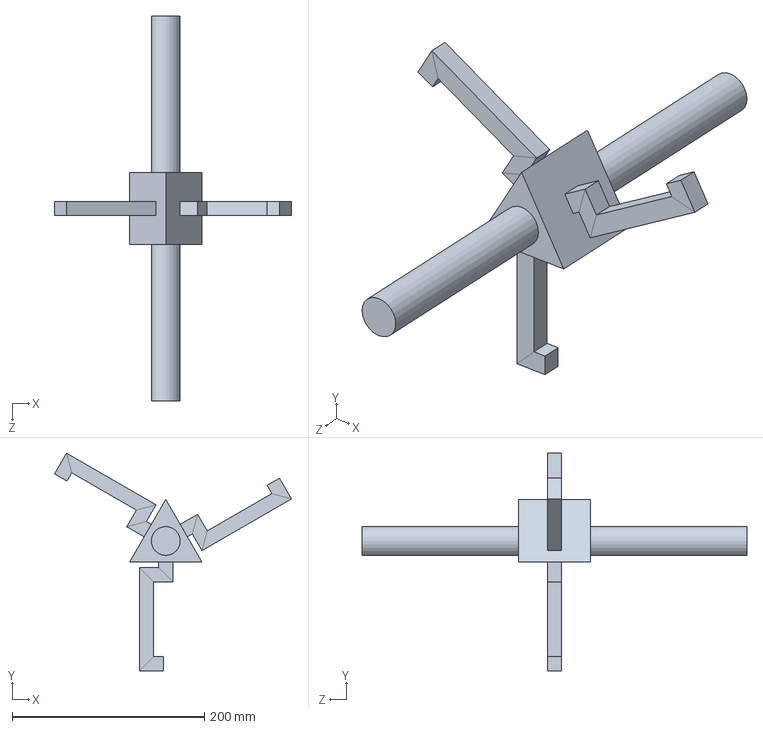
[picture p62: CAD file, 2023-12-29]
conception/la roue/Pièce4.SLDPRT
246.4 x 226.5 x 400.0 mm
