haoy1657/stage_2021_pprime/conception/Motedis Profile 45x45L B-Type slot 10.stp.SLDPRT

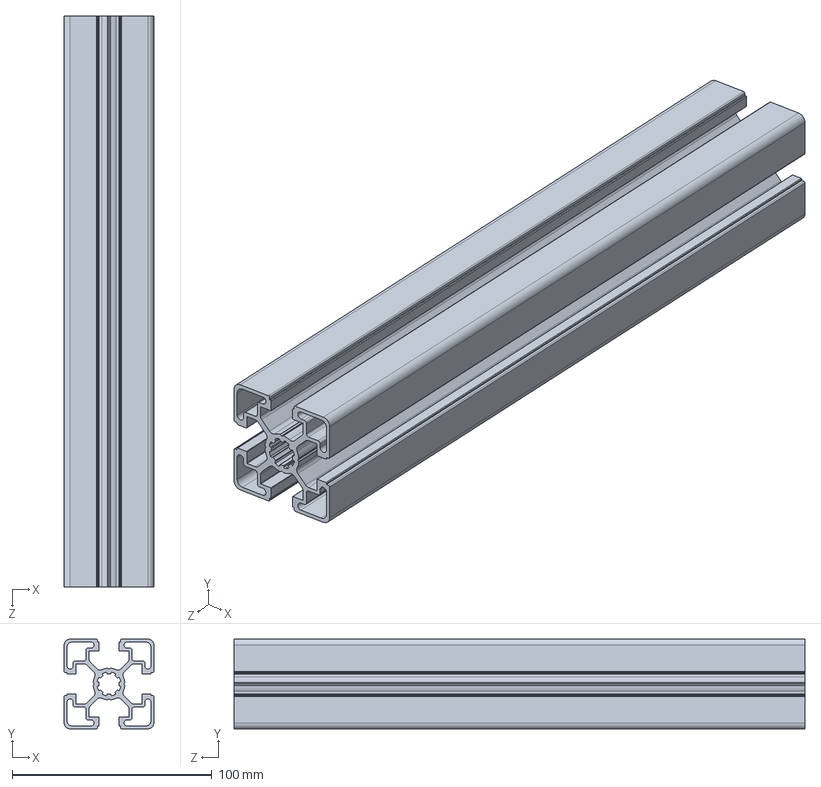
[picture p63: CAD file, 2023-12-29]
conception/Motedis Profile 45x45L B-Type slot 10.stp.SLDPRT
45.0 x 45.0 x 286.1 mm
