haoy1657/stage_2021_pprime/conception/vis a tete hexagonale M12x30  pas 1.75/din_en_24018_m12x30.SLDPRT

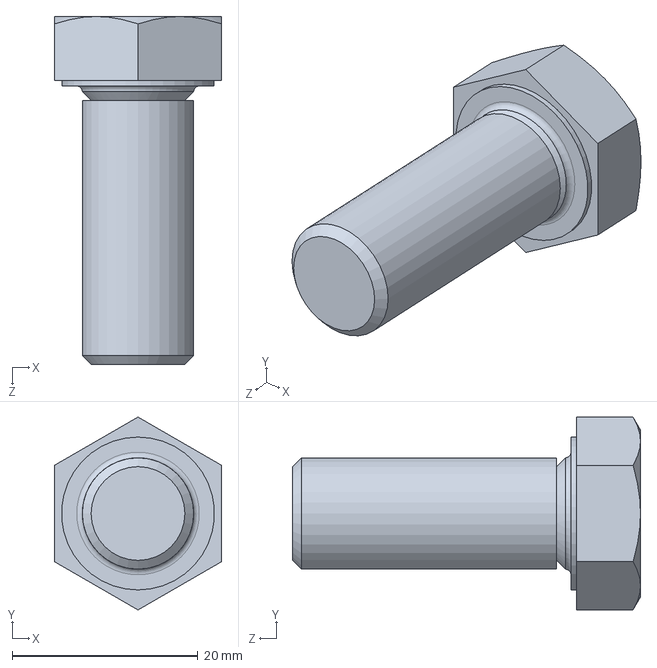
[picture p64: CAD file, 2023-12-29]
conception/vis a tete hexagonale M12x30 pas 1.75/din_en_24018_m12x30.SLDPRT
18.0 x 20.8 x 37.5 mm
