haoy1657/stage_2021_pprime/conception/vis a tete hexagonale M12x35 pas 1.75/din_en_24018_m12x35.SLDPRT

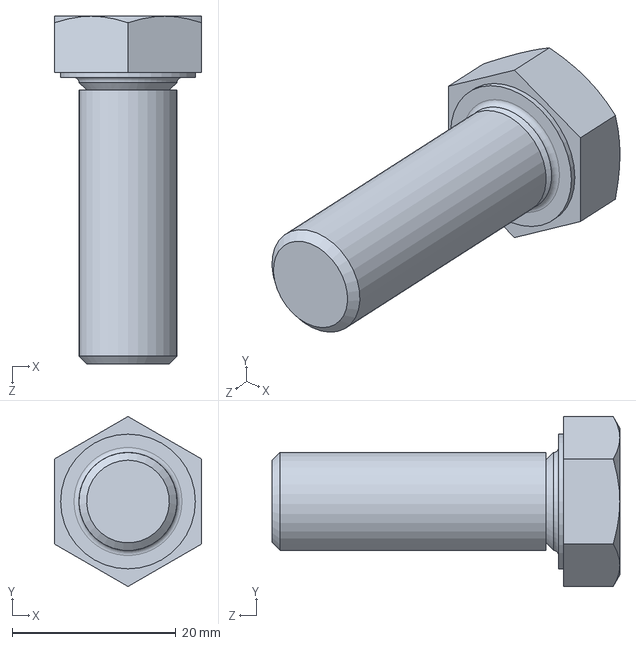
[picture p65: CAD file, 2023-12-29]
conception/vis a tete hexagonale M12x35 pas 1.75/din_en_24018_m12x35.SLDPRT
18.0 x 20.8 x 42.5 mm
