haoy1657/stage_2021_pprime/conception/vis M5 x12/fixe00e5569.SLDPRT

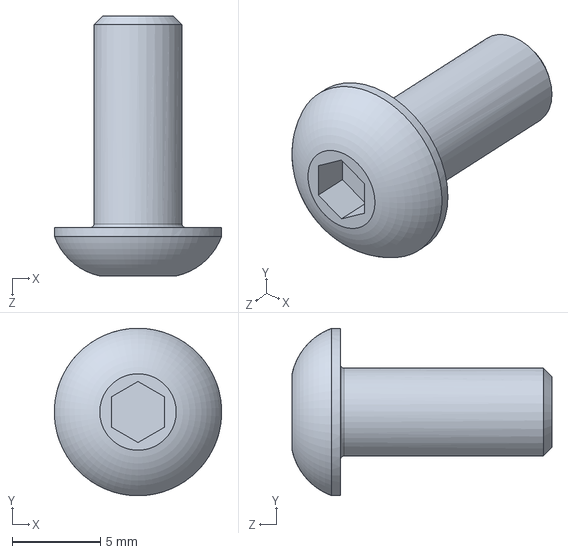
[picture p66: CAD file, 2023-12-29]
conception/vis M5 x12/fixe00e5569.SLDPRT
9.50 x 9.50 x 14.8 mm
