haoy1657/stage_2021_pprime/conception/vis m8x45/fixe00e5601.SLDPRT

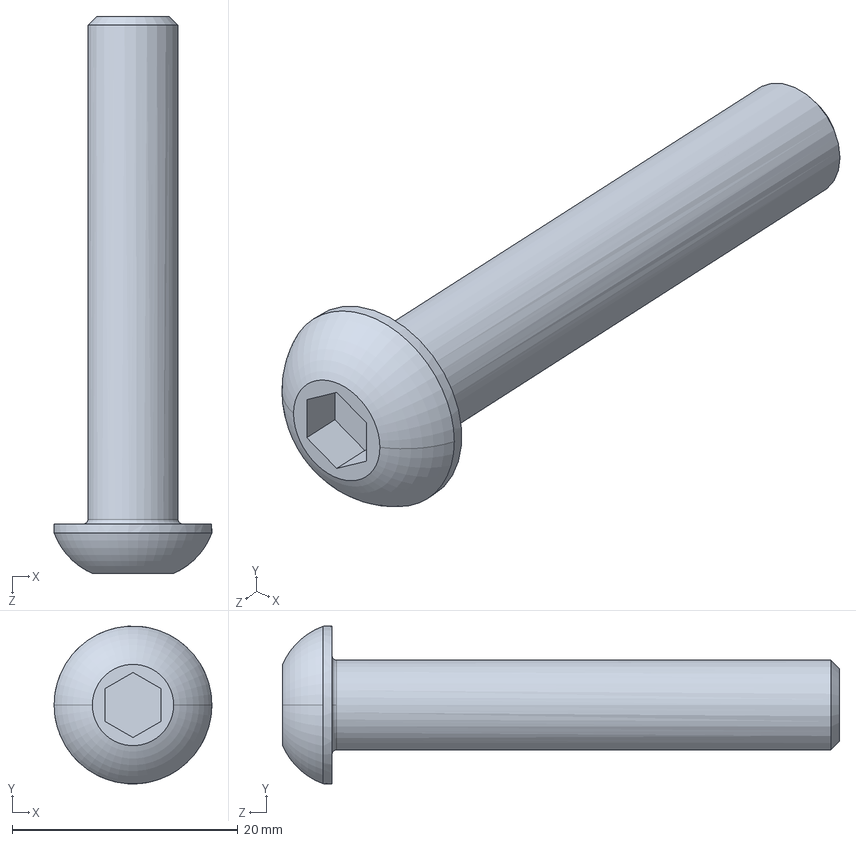
[picture p67: CAD file, 2023-12-29]
conception/vis m8x45/fixe00e5601.SLDPRT
14.0 x 14.0 x 49.4 mm
