haoy1657/stage_2021_pprime/conception/la roue/Pièce1.SLDPRT

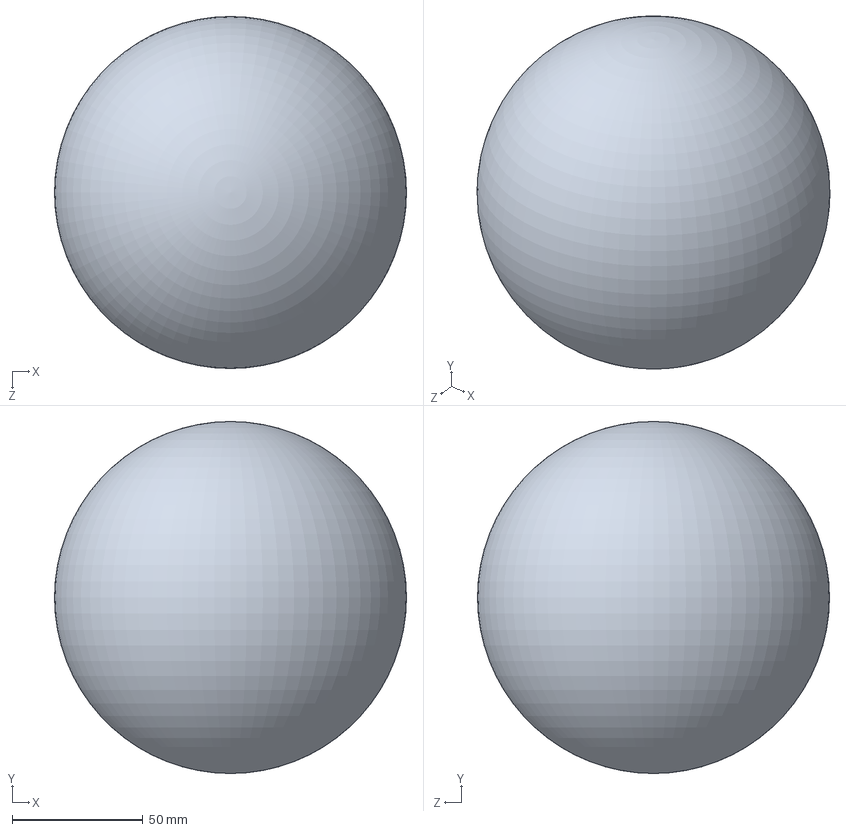
[picture p68: CAD file, 2023-12-29]
conception/la roue/Pièce1.SLDPRT
134.6 x 134.6 x 134.6 mm
