haoy1657/stage_2021_pprime/conception/Motedis Profile 45x45L B-Type slot 10/Motedis Profile 45x45L B-Type slot 10.stp

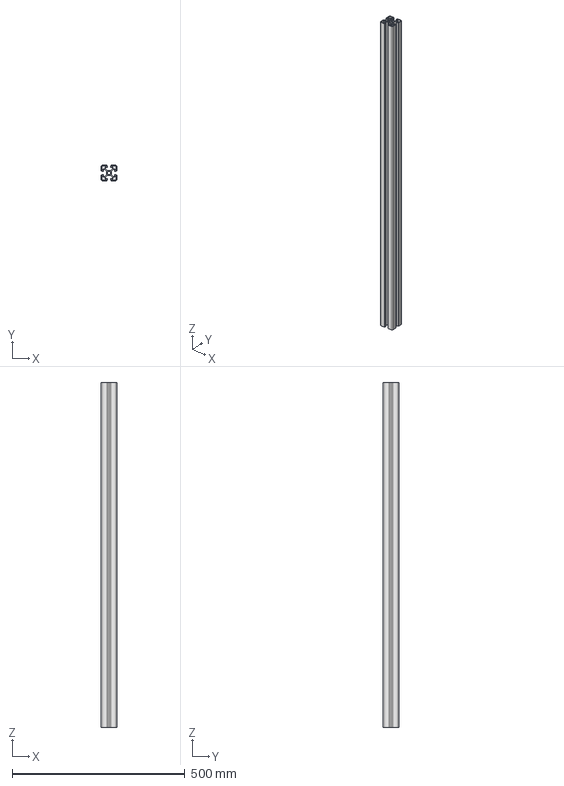
[picture p69: CAD file, 2023-12-29]
conception/Motedis Profile 45x45L B-Type slot 10/Motedis Profile 45x45L B-Type slot 10.stp
45.0 x 45.0 x 1000.0 mm
