haoy1657/stage_2021_pprime/conception/plaque sup.SLDPRT

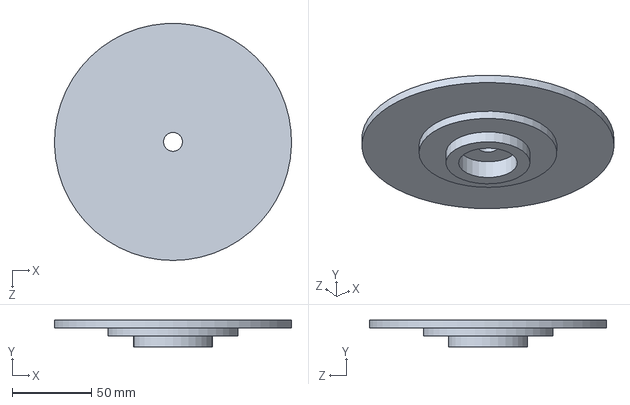
[picture p70: CAD file, 2023-12-29]
conception/plaque sup.SLDPRT
149.9 x 16.8 x 149.9 mm
