haoy1657/stage_2021_pprime/conception/vis M8 x20 pas 1.25/din_en_24018_m8x20.SLDPRT

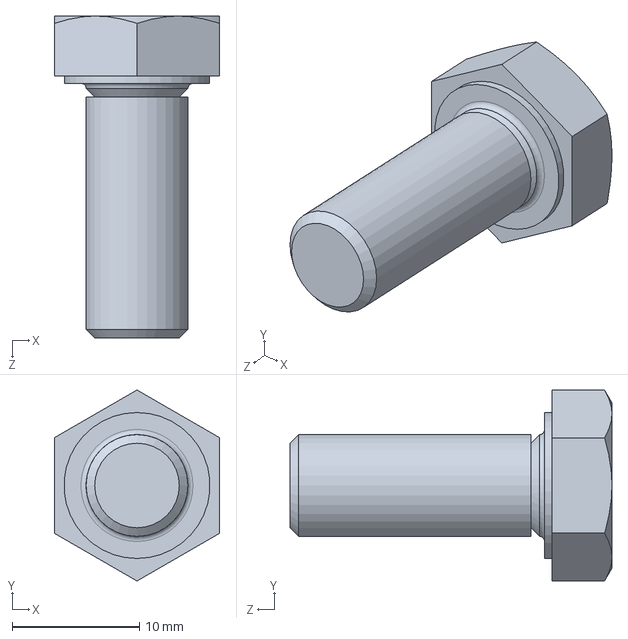
[picture p71: CAD file, 2023-12-29]
conception/vis M8 x20 pas 1.25/din_en_24018_m8x20.SLDPRT
13.0 x 15.0 x 25.3 mm
