haoy1657/stage_2021_pprime/conception/la roue/Pièce3.SLDPRT

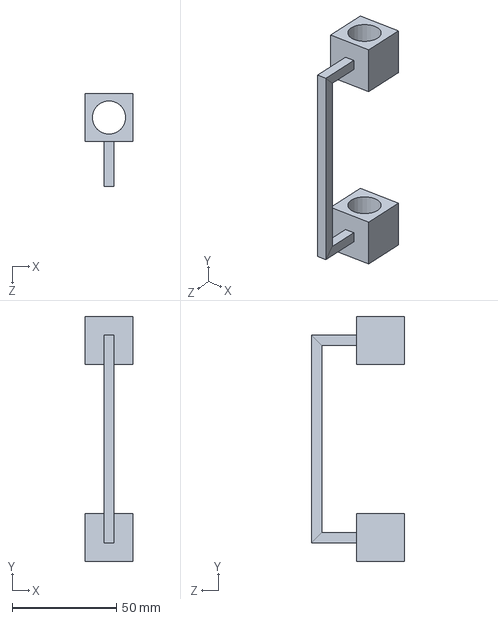
[picture p72: CAD file, 2023-12-29]
conception/la roue/Pièce3.SLDPRT
23.0 x 117.8 x 44.6 mm
