haoy1657/stage_2021_pprime/conception/Pièce1.SLDPRT

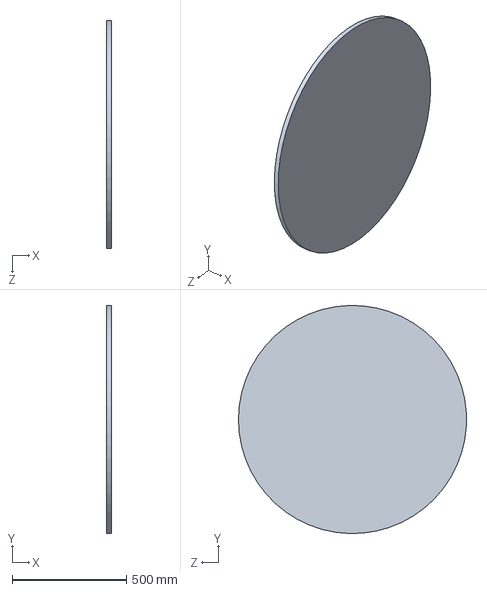
[picture p73: CAD file, 2023-12-29]
conception/Pièce1.SLDPRT
20.0 x 999.6 x 1000.0 mm
