haoy1657/stage_2021_pprime/conception/Motedis Profile 45x45L B-Type slot 10.SLDPRT 3.SLDPRT

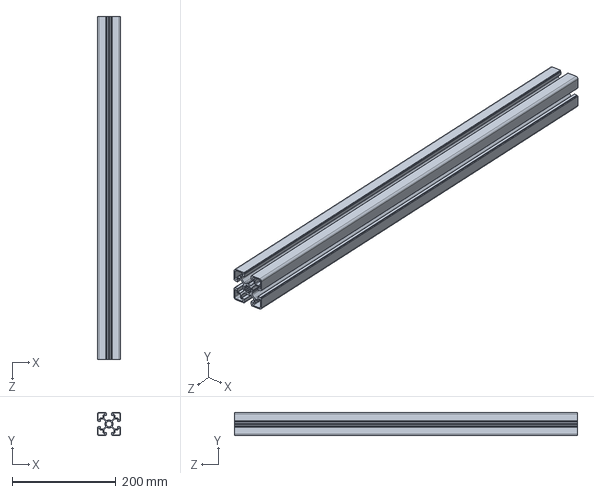
[picture p74: CAD file, 2023-12-29]
conception/Motedis Profile 45x45L B-Type slot 10.SLDPRT 3.SLDPRT
45.0 x 45.0 x 662.1 mm
