haoy1657/stage_2021_pprime/conception/la roue/Pièce2.SLDPRT

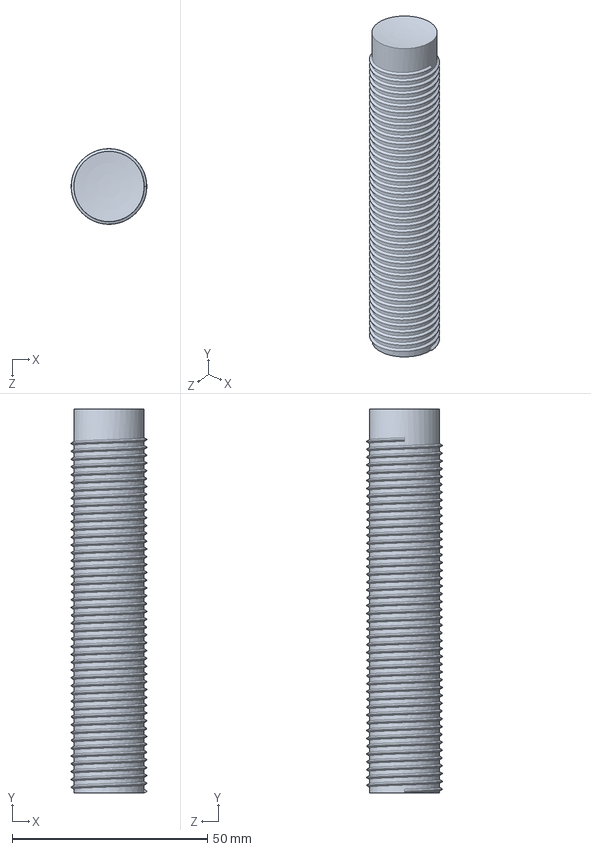
[picture p75: CAD file, 2023-12-29]
conception/la roue/Pièce2.SLDPRT
19.4 x 98.3 x 19.4 mm
