haoy1657/stage_2021_pprime/conception/Pièce4.SLDPRT

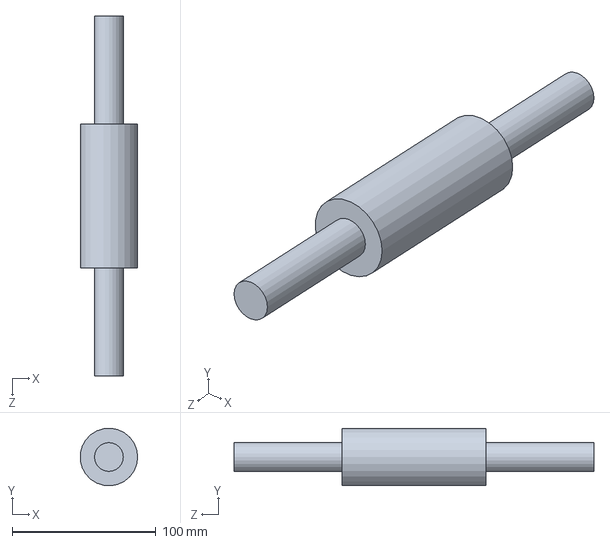
[picture p76: CAD file, 2023-12-29]
conception/Pièce4.SLDPRT
39.8 x 39.9 x 250.0 mm
