haoy1657/stage_2021_pprime/conception/arbre.SLDPRT

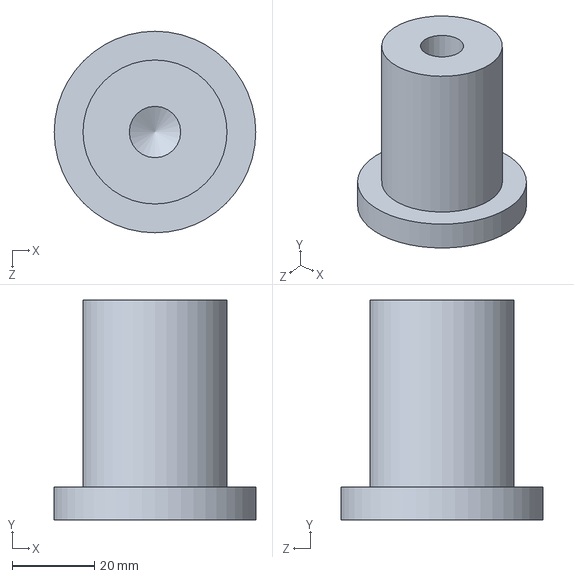
[picture p77: CAD file, 2023-12-29]
conception/arbre.SLDPRT
49.0 x 53.5 x 49.0 mm
