haoy1657/stage_2021_pprime/conception/plqaue .SLDPRT

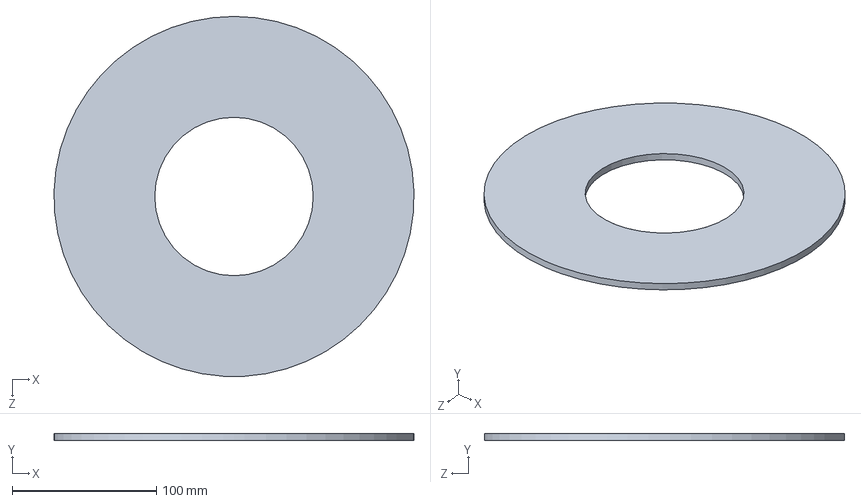
[picture p78: CAD file, 2023-12-29]
conception/plqaue .SLDPRT
249.9 x 5.00 x 250.0 mm
