haoy1657/stage_2021_pprime/conception/entretoise.SLDPRT

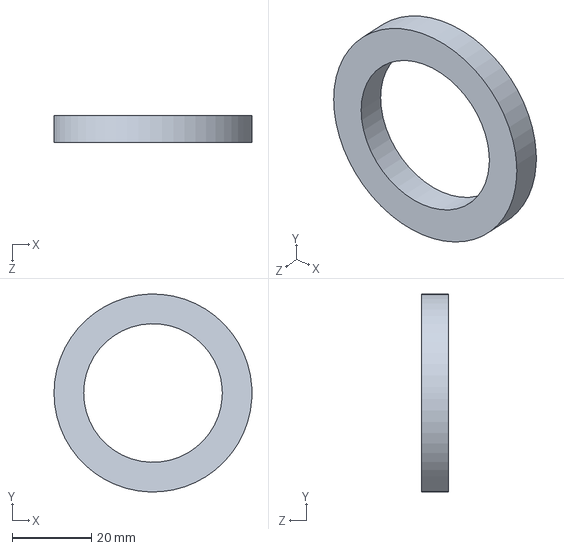
[picture p79: CAD file, 2023-12-29]
conception/entretoise.SLDPRT
50.0 x 50.0 x 6.83 mm
