haoy1657/stage_2021_pprime/conception/boitier.SLDPRT

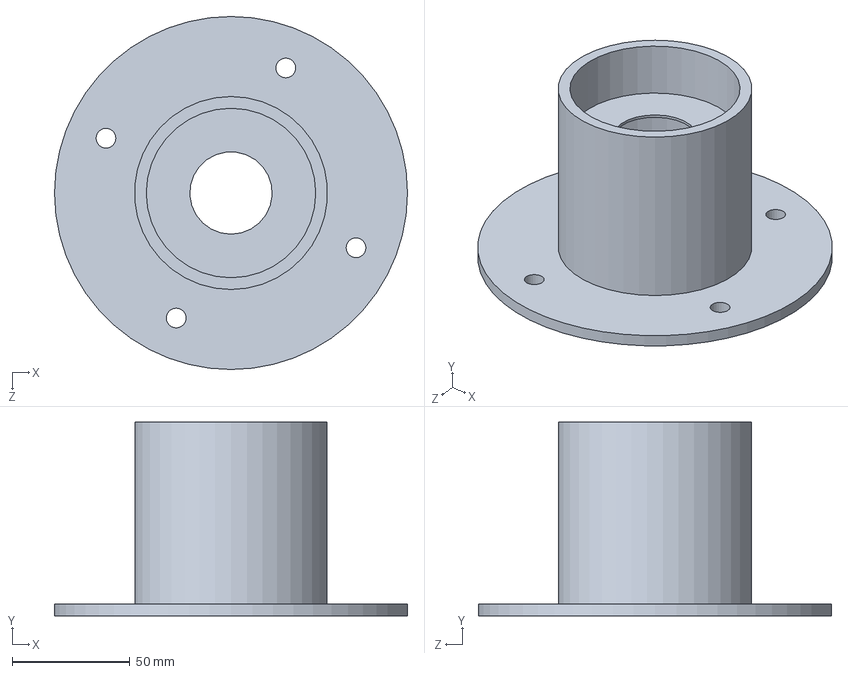
[picture p80: CAD file, 2023-12-29]
conception/boitier.SLDPRT
150.0 x 82.3 x 150.0 mm
