haoy1657/stage_2021_pprime/(list of files, cad)

Other CAD files:
conception/SKF_CAD_MODEL_SKF_7207 BE-2RZP/SOLIDWORKS/SKF_7207_BE_2RZP.sldasm
conception/114864418-7-snr_51104_2/snr_51104_2_01.SLDPRT
conception/SKF_CAD_MODEL_SKF_7207 BE-2RZP/SOLIDWORKS/SKF_7207_BE_2RZP_18.sldprt
conception/114864418-7-snr_51104_2/snr_51104_2_02.SLDPRT
conception/114864418-7-snr_51104_2/snr_51104_2_03.SLDPRT
conception/SKF_CAD_MODEL_SKF_7207 BE-2RZP/SOLIDWORKS/SKF_7207_BE_2RZP_3.sldprt
conception/SKF_CAD_MODEL_SKF_7207 BE-2RZP/SOLIDWORKS/SKF_7207_BE_2RZP_16.sldprt
conception/plateau du bois.SLDPRT
